Antonio-1110/RB4107_AY2627/docs/safety_rules.md

# Safety rules: what the controller does, and when

<!-- Generated by tools/safety_rules.py from firmware/components/safety/src/safety_rules.def. Do not edit: change the table and run `python3 tools/safety_rules.py gen`. -->

Every condition the S3 controller reacts to, and what it does. The state
machine runs from the same table this page is generated from
([`safety_rules.def`](../firmware/components/safety/src/safety_rules.def)), so
the transitions below are exactly what the firmware does. Values in **bold**
are the menuconfig defaults. The dashboard changes the ones listed in the last
section and shows the values in force; the rest are fixed (menuconfig or safety.c). The
reasons behind the rules are in [safety_state_machine.md](safety_state_machine.md).

## Outputs per state

| State | Buzzer | Shutdown output (latched) |
|---|---|---|
| BOOT | off | released |
| SELF_TEST | off | released |
| IDLE | off | released |
| MONITORING | off | released |
| UNATTENDED | off | released |
| WARNING | warning pattern | released |
| SHUTDOWN | shutdown pattern | **active** |
| FAULT | fault pattern | released |

## A. What the controller believes about its inputs

| # | When | Result | Code |
|---|---|---|---|
| A1 | A node sends nothing for **2 s** (stale) or **10 s** (offline), or its sensor reports invalid | That sensor's reading is UNKNOWN | `sensor_node_evaluate()` in `sensor_node/src/sensor_node.c` |
| A2 | "At the stove" (**"every working radar sees them"**): any working radar says absent | ABSENT | `presence_fuse_all()` in `sensor_node/src/sensor_node.c` |
| A3 | "At the stove": every working radar sees someone (a radar that is down is not asked) | PRESENT | `presence_fuse_all()` in `sensor_node/src/sensor_node.c` |
| A4 | No radar is working | UNKNOWN: a dashboard flag, never FAULT | `presence_fuse_all()` in `sensor_node/src/sensor_node.c` |
| A5 | Fusion set to "either radar sees them" (menuconfig or dashboard) | PRESENT if any radar sees someone; ABSENT only if all validly say absent | `presence_fuse()` in `sensor_node/src/sensor_node.c` |
| A6 | Radar rules set to enforce (default **"observe: computed and reported, not used"**): a radar sees someone but not for **4 s** with **1.5 s** stationary and within **60 cm** over **4 s** | That radar counts as absent (only passing). In observe mode the verdict is shown but not used | `node_set_inputs()` in `sensor_node/src/sensor_node.c` |
| A7 | Presence UNKNOWN while cooking | Counts as ABSENT. With nothing cooking, UNKNOWN starts no timer | `effective_presence()` in `safety/src/safety.c` |
| A8 | Thermal camera lost or invalid | Dashboard flag only. Cooking state, tier and a running countdown are kept | `safety_step()` in `safety/src/safety.c` |

## B. Cooking on or off (hottest pixel)

| # | When | Result | Code |
|---|---|---|---|
| B1 | Not cooking, and the hottest pixel reaches the cooking temperature **50 °C** (dashboard can change it), unless it is still falling (B6) | Cooking. A pan that is hot but falling (one just put in view, or switched off) is not cooking yet; it counts as cooking once the fall is under **0.2 °C/min** per minute. An unknown rate never blocks | `safety_step()` in `safety/src/safety.c` |
| B2 | Not cooking, above the off temperature and rising at least the heat-on rate (**0 °C/min**; 0 = this rule is off), and not still falling (B6) | Cooking | `safety_step()` in `safety/src/safety.c` |
| B3 | Cooking, and the hottest pixel falls below the off temperature **47 °C**: a pan that holds steady or is turned down has to fall this far | Not cooking | `safety_step()` in `safety/src/safety.c` |
| B6 | Cooking, the hottest pixel below **60 °C** and the thermal node's rate falling by **0.5 °C/min** per minute or more | Not cooking, even above the off temperature (B3). A pan that is still hot but cooling down stops counting as cooking | `safety_step()` in `safety/src/safety.c` |
| B4 | The dashboard sets a new cooking temperature | The off temperature moves with it, keeping the menuconfig gap (**50 °C** - **47 °C**) | `apply_cooking_temp()` in `rb_controller/src/rb_controller.c` |
| B5 | Every step: the thermal node's room temperature (the 10th-percentile pixel of the frame) | The room temperature in use, kept between **36 °C** and **45 °C**; **38 °C** without a camera reading. D1 and D5 compare the pan with it | `room_update()` in `safety/src/safety.c` |

## C. Timers

| # | When | Result | Code |
|---|---|---|---|
| C1 | First ABSENT reading | The absence count starts. A presence blip does not restart it; only a confirmed return (D4) stops it | `safety_step()` in `safety/src/safety.c` |
| C2 | Entering UNATTENDED | The countdown is counted from when the absence began, never from before cooking started | `on_enter()` in `safety/src/safety.c` |
| C3 | Hottest pixel below every hotter tier (tier 1: a simmer, boiling water) | The base times: buzzer after **150 s**, shutdown after **300 s** | `update_tier()` in `safety/src/safety.c` |
| C4 | Hottest pixel at least **100 °C** (tier 2), **150 °C** (tier 3), **200 °C** (tier 4) or **250 °C** (tier 5), for **4 s** | Buzzer / shutdown after **120 s** / **240 s** (tier 2), **90 s** / **180 s** (tier 3), **60 s** / **120 s** (tier 4), **30 s** / **60 s** (tier 5), if shorter than the base times. The hottest tier that applies wins | `update_tier()` in `safety/src/safety.c` |
| C5 | Rate rule (**on** by default): the temperature, plus its rise over the last **30 s** times a tier's buzzer time, reaches that tier's temperature, for **4 s** | That tier already: the buzzer sounds no later than the moment the pan would get there. The rise is the median of the newer half of the window minus the median of the older half, so one bad frame fakes no rise. Only a rise counts | `tier_for()` in `safety/src/safety.c` |
| C6 | **10 °C** below the tier's threshold (and not heading back, C5) for **20 s** | Back to the lower tier | `update_tier()` in `safety/src/safety.c` |
| C7 | The tier changes during a countdown | The countdown is not restarted: the time already away counts against the new limits. If they are already passed the buzzer sounds at once, and the shutdown waits for **10 s** of buzzer | `evaluate()` in `safety/src/safety.c` |
| C8 | Someone is seen during UNATTENDED or WARNING | The countdown stands still. At most **30 s** per countdown, and at most **25 %** of the shutdown time | `pause_clock()` in `safety/src/safety.c` |

## D. Holds and returns

| # | When | Result | Code |
|---|---|---|---|
| D1 | Cooling: a straight line fitted to the hot region (the mean around the hottest pixel) over the last **120 s** (at least **12** samples over **60 s**; recent samples count more, and samples a first fit misses by over **3** robust SDs, at least **0.5 °C**, are left out) shows the pan falling at least as fast as cooling alone would make a pan that settles **3 °C** below the only-cooling line fall: (T - line + margin) / tau. The rate must be clear of that by **2** standard errors of the fit. The line is **10 °C** above the room temperature (B5), but never above the cooking temperature: Newton cooling settles at the room. T + tau x rate (where it is heading) also rose at most **8 °C/min** over the last minute. tau comes from the cookware profile (**"mixed / unknown (10 min)"**) | The pan counts as only cooling. Ends when it falls slower than a pan settling **3 °C** above the line would, or T + tau x rate climbs faster than **16 °C/min** plus its own noise (**2** x 1.4 x tau x the rate's standard error). With too little data, a lost camera or the trend judgment turned off (it is **on** by default), heat counts as going in | `judge_heat()` in `safety/src/safety.c` |
| D2 | A buzzer or shutdown comes due while the pan is only cooling (D1) | It waits (cooling hold), at most **4** tau and never over **3600 s**. The countdown keeps counting; a buzzer already sounding keeps sounding | `hold_reason()` in `safety/src/safety.c` |
| D3 | A step comes due while someone is seen but not yet confirmed (D4) | It waits (return hold), at most **5 s** + **1 s** | `hold_reason()` in `safety/src/safety.c` |
| D4 | Someone returns: PRESENT for **5 s**, absent gaps under **1 s** forgiven, still present at the end | Return confirmed (used by T10, T13) | `present_confirmed()` in `safety/src/safety.c` |
| D5 | A buzzer or shutdown comes due while the temperature is falling (over the last **30 s**) by at least **2** % per minute of its heat above the room (B5), and at least **1 °C/min**; near the room even a switched-off pan falls slowly. And the trend has not confirmed heat going in (the fit of D1 falling slower than a pan settling **3 °C** above the only-cooling line would, and T + tau x rate moving at most **8 °C/min**) | It waits (falling hold; **on** by default): a falling pan is moving away from danger. Ends at once when the temperature stops falling or heat is confirmed (a lowered flame), and after **90 s** at most per countdown (a check before it, D6, uses up the same limit). A pan that is only cooling (D1) gets the cooling hold instead | `falling_hold()` in `safety/src/safety.c` |
| D6 | Absence confirmed while cooking (MONITORING): for the first half of **30 s** of the absence (a fall takes that long to show), unless the pan is rising or the buzzer is already due; after that, while the pan falls as for the falling hold (D5) | The countdown waits to start (checking: stove off or turned down?), so no unattended episode opens. It still counts from when the absence began (C2), so the buzzer is never later for it. Ends when the pan is not falling after the first look (the countdown starts), when cooking stops (T08, B6), on a confirmed return, and after **90 s** at most, shared with D5. A countdown that starts after a check that saw the pan falling counts as held: the buzzer lasts **30 s** before a shutdown | `g_absent_unheld()` in `safety/src/safety.c` |

## T. State transitions

Checked on every step in this order; the first rule of the current state that holds is taken.

| # | From | When | To | Reported reason |
|---|---|---|---|---|
| T01 | BOOT | Always | **SELF_TEST** | boot complete |
| T02 | SELF_TEST | The self-test reports FAIL | **FAULT** | self-test failed |
| T03 | SELF_TEST | The self-test reports PASS | **IDLE** | self-test passed |
| T04 | SELF_TEST | No self-test result within **10 s** | **FAULT** | self-test timeout |
| T05 | any cooking-related state (IDLE, MONITORING, UNATTENDED, WARNING) | The self-test (the shutdown output's read-back, every **1 s**) no longer passes | **FAULT** | self-test not passed |
| T06 | any cooking-related state (IDLE, MONITORING, UNATTENDED, WARNING) | A controller fault in the fault list (shutdown output, self-test). A lost sensor is not one (A4, A8) | **FAULT** | safety-relevant fault active |
| T07 | IDLE | Cooking (B1, B2) | **MONITORING** | heating detected |
| T08 | MONITORING | Not cooking (B3) | **IDLE** | heating stopped |
| T09 | MONITORING | ABSENT for **1 s** (C1), and not checking (D6) | **UNATTENDED** | person absent |
| T10 | UNATTENDED | Return confirmed (D4). The countdown is cancelled | **MONITORING** | person returned |
| T11 | UNATTENDED | Not cooking (B3), with the cooling policy **"return to IDLE and cancel the timers"**. The countdown is cancelled | **IDLE** | heating stopped while unattended |
| T12 | UNATTENDED | Unattended for the warning time (**150 s**, shorter in a hotter tier C4, C5) and no hold (D2, D3, D5) | **WARNING** | unattended timeout |
| T13 | WARNING | Return confirmed (D4). The warning exit is **"return to MONITORING"**; if menuconfig changes it to acknowledge, a reset is needed as well | **MONITORING** | person returned during warning |
| T14 | WARNING | Not cooking (B3), with the cooling policy **"return to IDLE and cancel the timers"**. The countdown is cancelled | **IDLE** | heating stopped during warning |
| T15 | WARNING | Unattended for the shutdown time (**300 s**, counted from **"start of UNATTENDED (total unattended time)"**, shorter in a hotter tier), no hold (D2, D3, D5), and the buzzer has sounded at least **30 s** if a hold happened, or **10 s** if a tier made the shutdown due at once | **SHUTDOWN** | shutdown timeout |
| T16 | SHUTDOWN | Operator reset (dashboard button or console reset). Nothing else leaves SHUTDOWN; a reboot also clears it. All timing starts over | **IDLE** | operator reset |
| T17 | FAULT | Fault cleared, not cooking | **IDLE** | fault cleared, no heating |
| T18 | FAULT | Fault cleared, cooking, PRESENT | **MONITORING** | fault cleared, person present |
| T19 | FAULT | Fault cleared, cooking, nobody seen. A countdown already running carries on; otherwise it counts from when the fault began | **UNATTENDED** | fault cleared, person absent |
| T20 | FAULT | The countdown reached its shutdown time: a fault never postpones it | **SHUTDOWN** | shutdown timeout reached during fault |
| T21 | FAULT | In FAULT for **90 s** (0 = never, menuconfig only) | **SHUTDOWN** | fault persisted |

SHUTDOWN is left only by T16. A state not in the table goes to FAULT ("invalid state").

## X. Outside the state machine

| # | When | Result | Code |
|---|---|---|---|
| X2 | MQTT, Django, the laptop or the network is down | No effect on any rule: the safety task never waits on them, and the settings the dashboard gave it stay in force (saved on the controller) | `safety_task()` in `rb_controller/src/rb_controller.c` |

## Settings

Menuconfig: RB4107 configuration. Values in Kconfig units.

| Setting | Default | What it is |
|---|---|---|
| `RB_CTRL_NODE_OFFLINE_MS` | 10000 | Node OFFLINE after (ms) without a packet |
| `RB_CTRL_NODE_STALE_MS` | 2000 | Node STALE after (ms) without a packet |
| `RB_CTRL_PRESENCE_FUSION` | every working radar sees them | Someone counts as at the stove when ... |
| `RB_CTRL_RADAR_DWELL_MS` | 4000 | Time in the cook zone needed to count as dwelling (ms) |
| `RB_CTRL_RADAR_RULES` | observe: computed and reported, not used | Radar state and distance rules (placeholder, untuned) |
| `RB_CTRL_RADAR_SETTLE_SPAN_CM` | 60 | ... to within a span of (cm) |
| `RB_CTRL_RADAR_SETTLE_WINDOW_MS` | 4000 | The distance must have settled over the last (ms) ... |
| `RB_CTRL_RADAR_STATIONARY_MIN_MS` | 1500 | ... of which as a stationary target at least (ms) |
| `RB_SAFETY_ABSENCE_DEBOUNCE_MS` | 1000 | Absence must last (ms) before UNATTENDED |
| `RB_SAFETY_COOKING_TREND` | y | Judge from the temperature trend whether heat is going in |
| `RB_SAFETY_COOKWARE` | mixed / unknown (10 min) | Cookware profile (how fast the pans lose heat) |
| `RB_SAFETY_COOLING` | return to IDLE and cancel the timers | Pan drops below the cooking temperature while UNATTENDED/WARNING |
| `RB_SAFETY_FALLING_HOLD` | y | Hold a due buzzer or shutdown while the temperature is falling |
| `RB_SAFETY_FAULT_SHUTDOWN_S` | 90 | Shut down after this long in FAULT (s, 0 = never) |
| `RB_SAFETY_HEAT_OFF_DC` | 470 | Cooking over below hottest-pixel temperature (0.1 degC) |
| `RB_SAFETY_HEAT_ON_DC` | 500 | Cooking detected at hottest-pixel temperature (0.1 degC) |
| `RB_SAFETY_HEAT_ON_RATE_DC_PER_MIN` | 0 | Also detect cooking when rising at least (0.1 degC/min), 0 = off |
| `RB_SAFETY_PAUSE_BUDGET_PCT` | 25 | ... and at most this share of the shutdown time (%) |
| `RB_SAFETY_PAUSE_BUDGET_S` | 30 | Pause budget per timeline (s, 0 = never pause) |
| `RB_SAFETY_PRESENCE_RETURN_DEBOUNCE_MS` | 5000 | Presence must last (ms) to cancel UNATTENDED/WARNING |
| `RB_SAFETY_PRESENCE_RETURN_GAP_MS` | 1000 | Gaps shorter than this (ms) don't restart the presence count |
| `RB_SAFETY_SELF_TEST_TIMEOUT_MS` | 10000 | Self-test timeout (ms) |
| `RB_SAFETY_SHUTDOWN_TIMEOUT_S` | 300 | Shutdown timeout (s) |
| `RB_SAFETY_SHUTDOWN_TIMING` | start of UNATTENDED (total unattended time) | Shutdown timeout counts from |
| `RB_SAFETY_TEMP_TIERS` | y | Shorter buzzer and shutdown times for hotter pans |
| `RB_SAFETY_TIER_2_SHUTDOWN_S` | 240 | Tier 2: shutdown time (s, counted like the base shutdown time) |
| `RB_SAFETY_TIER_2_TEMP_DC` | 1000 | Tier 2 from a hottest-pixel temperature of (0.1 degC) |
| `RB_SAFETY_TIER_2_WARNING_S` | 120 | Tier 2: unattended time before WARNING (s) |
| `RB_SAFETY_TIER_3_SHUTDOWN_S` | 180 | Tier 3: shutdown time (s, counted like the base shutdown time) |
| `RB_SAFETY_TIER_3_TEMP_DC` | 1500 | Tier 3 from a hottest-pixel temperature of (0.1 degC) |
| `RB_SAFETY_TIER_3_WARNING_S` | 90 | Tier 3: unattended time before WARNING (s) |
| `RB_SAFETY_TIER_4_SHUTDOWN_S` | 120 | Tier 4: shutdown time (s, counted like the base shutdown time) |
| `RB_SAFETY_TIER_4_TEMP_DC` | 2000 | Tier 4 from a hottest-pixel temperature of (0.1 degC) |
| `RB_SAFETY_TIER_4_WARNING_S` | 60 | Tier 4: unattended time before WARNING (s) |
| `RB_SAFETY_TIER_5_SHUTDOWN_S` | 60 | Tier 5: shutdown time (s, counted like the base shutdown time) |
| `RB_SAFETY_TIER_5_TEMP_DC` | 2500 | Tier 5 from a hottest-pixel temperature of (0.1 degC) |
| `RB_SAFETY_TIER_5_WARNING_S` | 30 | Tier 5: unattended time before WARNING (s) |
| `RB_SAFETY_TIER_RATE` | y | Also use the tier a rising pan is heading for |
| `RB_SAFETY_WARNING_EXIT` | return to MONITORING | Person returns during WARNING |
| `RB_SAFETY_WARNING_TIMEOUT_S` | 150 | Unattended time before WARNING (s) |
| `RB_SHUTDOWN_VERIFY_PERIOD_MS` | 1000 | Read back and verify the relay output every (ms) |

## Fixed constants in safety.c

| Constant | Value | Note |
|---|---|---|
| `TIER_UP_PERSIST_MS` | 4000 | a hotter tier takes over after holding this long |
| `TIER_DOWN_PERSIST_MS` | 20000 | a cooler one only after this long ... |
| `TIER_HYST_C` | 10.0 | ... and this far below the threshold |
| `LATE_WARNING_MIN_MS` | 10000 | buzzer before a shutdown that was already due |
| `TREND_SAMPLE_MS` | 2000 | one sample per 2 s |
| `TREND_GAP_RESET_MS` | 15000 | a longer silence starts the trend over |
| `TREND_STALE_MS` | 30000 | no sample for this long: the trend is unknown |
| `TREND_DEFAULT_WINDOW_MS` | 120000 | regression window when the config leaves it 0 |
| `TREND_MIN_SPAN_MS` | 60000 | needs at least this much history ... |
| `TREND_MIN_SAMPLES` | 12 | ... and this many samples |
| `TREND_CONFIDENCE` | 2.0 |  |
| `TREND_OUTLIER_MADS` | 3.0 | a sample this many robust SDs off the first fit is left out of the second |
| `TREND_OUTLIER_MIN_C` | 0.5 | ... but never one closer than this |
| `TREND_HALF_LIFE_MS` | 30000.0 | recent samples count more: a pan that was steady and now cools shows up sooner |
| `SETTLE_MARGIN_C` | 3.0 | hysteresis on the cooling decision |
| `HEAT_FALLING_OFF_C` | 60.0 |  |
| `HEAT_FALLING_C_PER_MIN` | 0.5 |  |
| `HEAT_FALLING_END_C_PER_MIN` | 0.2 |  |
| `ROOM_MIN_C` | 36.0 |  |
| `ROOM_MAX_C` | 45.0 |  |
| `ROOM_FALLBACK_C` | 38.0 |  |
| `ROOM_MARGIN_C` | 10.0 |  |
| `SETTLE_HIST_SAMPLE_MS` | 5000 | the settling estimate is remembered every 5 s ... |
| `SETTLE_DRIFT_WINDOW_MS` | 60000 | ... and its rise measured over a minute |
| `SETTLE_MAX_DRIFT_C_PER_MIN` | 8.0 | to start believing "cooling" |
| `SETTLE_EXIT_DRIFT_C_PER_MIN` | 16.0 | to stop believing it (hysteresis: camera noise must not drop a hold) |
| `RISING_C_PER_MIN` | 0.5 | faster than this is "heating", otherwise "holding" |
| `COOLING_HOLD_MAX_MS` | 3600000 | a cooling hold never lasts longer than an hour ... |
| `COOLING_HOLD_TAUS` | 4.0 | ... nor longer than 4 time constants: a pan still hot after that is not just cooling |
| `WARNING_MIN_AFTER_HOLD_MS` | 30000 | buzzer before the shutdown after any hold |
| `TIER_RATE_WINDOW_MS` | 30000 | rate for the tiers and the falling hold fitted over the last 30 s |
| `FALLING_SHARE_PCT_PER_MIN` | 2.0 | falling = losing at least this share of the heat above the room per minute |
| `FALLING_RATE_C_PER_MIN` | 1.0 | ... and at least this fast |
| `FALLING_HOLD_MAX_MS` | 90000 | a falling hold lasts at most this long per timeline |
| `SAFETY_FAST_RATE_MAX` | 64 | samples in that window at most: up to 126 s |

## Changing them from the dashboard

The dashboard's Safety tab changes the cooking temperature, cookware profile, temperature tiers,
presence filter and buzzer/shutdown times, fusion and pause budget, and the radar rules, plus the
settings below ([`rb_params.def`](../firmware/components/rb_params/include/rb_params.def)) under
each card's **More settings**. The controller saves them until **Restore menuconfig defaults** is pressed.
Everything else in these rules is fixed.

| Setting | Key | Default | Range |
|---|---|---|---|
| Cooking ends this far below the cooking temperature | `heat_off_gap_dc` | 3 °C | 0 °C to 100 °C |
| Hold while the pan is only cooling | `cooking_trend` | on | off / on |
| Maximum cooling hold | `cooling_hold_max_ms` | 3600 s | 60 s to 14400 s |
| Hold while the pan temperature is falling | `falling_hold` | on | off / on |
| Maximum falling hold | `falling_hold_max_ms` | 90 s | 10 s to 600 s |
| Minimum buzzer warning before shut-off after a hold | `warning_min_after_hold_ms` | 30 s | 1 s to 600 s |
| Apply a hotter tier early when the pan heats quickly | `tier_rate` | on | off / on |
| Gas shut-off after a controller fault lasting | `fault_shutdown_ms` | 90 s | 10 s to 3600 s |
