Antonio-1110/RB4107_AY2627/docs/configuration.md

# Configuration reference

Generated by `tools/diagnostics/kconfig_doc.py` from
[`firmware/components/rb_config/Kconfig`](../firmware/components/rb_config/Kconfig),
which is the one place every tunable is defined. Change values with
`idf.py menuconfig` → **RB4107 configuration**, or per project in `sdkconfig.defaults`.
Items flagged ⚠ are not yet confirmed on hardware or still open (see the GitHub issues).

## Logging

| Option | Description | Default | Range | |
|---|---|---|---|---|
| `CONFIG_RB_LOG_DEBUG_TAGS` | Tags to raise to DEBUG at boot (comma separated) | `""` |  |  |
| `CONFIG_RB_LOG_QUIET_TAGS` | Tags to lower to WARN at boot (comma separated) | `""` |  |  |

## ESP-NOW link (shared by node and controller)

| Option | Description | Default | Range | |
|---|---|---|---|---|
| `CONFIG_RB_ESPNOW_CHANNEL` | Wi-Fi channel used for ESP-NOW | `1` | 1 – 13 |  |
| `CONFIG_RB_ESPNOW_FOLLOW_CHANNEL` | Nodes: follow the controller when it changes channel | `y` |  | ⚠ |
| `CONFIG_RB_ESPNOW_LOST_FAILURES` | Nodes: search after this many unacknowledged packets in a row | `5` | 2 – 50 |  |

## Sensor node (ESP32-C6)

| Option | Description | Default | Range | |
|---|---|---|---|---|
| `CONFIG_RB_NODE_ID` | Sensor node ID | `1` | 1 – 65535 |  |
| `CONFIG_RB_NODE_ID_BY_MAC` | Node ID by MAC address (overrides Sensor node ID) | `""` |  |  |
| `CONFIG_RB_NODE_STATUS_LED_GPIO` | Status LED GPIO (-1 = none) | `15` | -1 – 30 |  |
| `CONFIG_RB_NODE_HEALTH_LOG_PERIOD_MS` | Board health log period (ms) | `10000` | 1000 – 600000 |  |
| `CONFIG_RB_NODE_CONTROLLER_MAC` | Controller (ESP32-S3) Wi-Fi STA MAC address | `"FF:FF:FF:FF:FF:FF"` |  |  |
| `CONFIG_RB_NODE_DATA_PERIOD_MS` | Data (PRESENCE_DATA / THERMAL_DATA) transmit period (ms) | `500` | 100 – 10000 |  |
| `CONFIG_RB_NODE_HEARTBEAT_PERIOD_MS` | HEARTBEAT transmit period (ms) | `1000` | 200 – 60000 |  |
| `CONFIG_RB_MLX_STALE_TIMEOUT_MS` | Thermal reading goes invalid after (ms) without a good frame | `3000` | 500 – 60000 |  |

## Sensor node (ESP32-C6) → C4002 presence sensor

| Option | Description | Default | Range | |
|---|---|---|---|---|
| `CONFIG_RB_C4002_UART_PORT` | UART port | `1` | 0 – 1 |  |
| `CONFIG_RB_C4002_RX_GPIO` | ESP32 RX GPIO (wired to C4002 TX) | `4` | 0 – 30 |  |
| `CONFIG_RB_C4002_TX_GPIO` | ESP32 TX GPIO (wired to C4002 RX) | `5` | 0 – 30 |  |
| `CONFIG_RB_C4002_OUT_GPIO` | C4002 OUT pin GPIO (-1 = not wired) | `-1` | -1 – 30 |  |
| `CONFIG_RB_C4002_BAUD` | Baud rate | `115200` |  |  |
| `CONFIG_RB_C4002_STALE_TIMEOUT_MS` | Reading goes invalid after (ms) without a report | `3000` | 200 – 60000 |  |
| `CONFIG_RB_C4002_APPLY_SETTINGS` | Push the detection settings below to the sensor at boot | `y` |  |  |
| `CONFIG_RB_C4002_REPORT_PERIOD_DS` | Report period (0.1 s units) | `5` | 1 – 5 |  |
| `CONFIG_RB_C4002_RANGE_MIN_CM` | Detection range minimum (cm) | `0` | 0 – 1100 |  |
| `CONFIG_RB_C4002_RANGE_MAX_CM` | Detection range maximum (cm) | `500` | 0 – 1100 |  |
| `RB_C4002_RESOLUTION` (choice) | Distance gate resolution: `CONFIG_RB_C4002_RESOLUTION_80CM` = 80 cm (15 gates, ~11 m); `CONFIG_RB_C4002_RESOLUTION_20CM` = 20 cm (25 gates, ~4.9 m) | `CONFIG_RB_C4002_RESOLUTION_20CM` |  |  |
| `CONFIG_RB_C4002_MOTION_SENSITIVITY` | Motion sensitivity group (0 low, 1 mid, 2 high) | `1` | 0 – 2 |  |
| `CONFIG_RB_C4002_PRESENCE_SENSITIVITY` | Static presence sensitivity group (0 low, 1 mid, 2 high) | `1` | 0 – 2 |  |
| `CONFIG_RB_C4002_DISAPPEAR_DELAY_S` | Target disappear delay (s) | `1` | 0 – 65535 |  |
| `CONFIG_RB_C4002_LOCK_TIME_DS` | Lock time after a target leaves (0.1 s units) | `10` | 2 – 100 |  |
| `CONFIG_RB_C4002_REMOTE_TUNING` | Accept C4002 settings and calibration from the dashboard | `y` |  |  |
| `CONFIG_RB_C4002_LIVE_PERIOD_MS` | Send raw C4002 results for the dashboard's live view every (ms), 0 = off | `250` | 0 – 10000 |  |
| `CONFIG_RB_C4002_ENV_CALIBRATION_AT_BOOT` | Run environment calibration at boot (area must be empty) | `n` |  |  |
| `CONFIG_RB_C4002_ENV_CALIBRATION_S` | Environment calibration duration (s) | `30` | 1 – 600 |  |

## Sensor node (ESP32-C6) → MLX90640 thermal sensor

| Option | Description | Default | Range | |
|---|---|---|---|---|
| `CONFIG_RB_MLX_I2C_PORT` | I2C port | `0` | 0 – 1 |  |
| `CONFIG_RB_MLX_SDA_GPIO` | SDA GPIO | `6` | 0 – 30 |  |
| `CONFIG_RB_MLX_SCL_GPIO` | SCL GPIO | `7` | 0 – 30 |  |
| `CONFIG_RB_MLX_I2C_HZ` | I2C clock (Hz) | `400000` | 100000 – 1000000 |  |
| `CONFIG_RB_MLX_ADDRESS` | I2C address | `0x33` |  |  |
| `RB_MLX_REFRESH` (choice) | Sub-page refresh rate: `CONFIG_RB_MLX_REFRESH_2HZ` = 2 Hz; `CONFIG_RB_MLX_REFRESH_4HZ` = 4 Hz; `CONFIG_RB_MLX_REFRESH_8HZ` = 8 Hz | `CONFIG_RB_MLX_REFRESH_4HZ` |  |  |
| `CONFIG_RB_MLX_EMISSIVITY_PCT` | Emissivity (percent) | `95` | 10 – 100 |  |
| `CONFIG_RB_MLX_FRAME_TIMEOUT_MS` | Frame read timeout (ms) | `2000` | 100 – 10000 |  |

## Sensor node (ESP32-C6) → Thermal feature extraction

| Option | Description | Default | Range | |
|---|---|---|---|---|
| `CONFIG_RB_THERMAL_HOT_PIXEL_THRESHOLD_DC` | Hot pixel threshold (0.1 degC) | `500` | -400 – 3000 |  |
| `CONFIG_RB_THERMAL_HOT_REGION_RADIUS` | Hot region radius (pixels) | `1` | 0 – 4 |  |
| `CONFIG_RB_THERMAL_RATE_WINDOW_S` | Rate-of-change window (s) | `30` | 4 – 600 |  |
| `CONFIG_RB_THERMAL_VALID_MIN_DC` | Lowest plausible pixel temperature (0.1 degC) | `-400` | -400 – 0 |  |
| `CONFIG_RB_THERMAL_VALID_MAX_DC` | Highest plausible pixel temperature (0.1 degC) | `3000` | 500 – 4000 |  |
| `CONFIG_RB_THERMAL_MAX_INVALID_PIXELS` | Invalid pixels tolerated per frame | `8` | 0 – 768 |  |
| `CONFIG_RB_THERMAL_DIAG_DUMP_EVERY` | Dump the raw frame over serial every N frames (0 = never) | `0` | 0 – 10000 |  |
| `CONFIG_RB_THERMAL_HEATMAP` | Send the heat-map picture to the controller (dashboard) | `y` |  |  |
| `CONFIG_RB_THERMAL_HEATMAP_PERIOD_MS` | Heat-map picture period (ms) | `3000` | 1000 – 10000 |  |
| `CONFIG_RB_THERMAL_REMOTE_THRESHOLD` | Accept the hot-pixel threshold from the controller | `y` |  |  |

## Controller board (Waveshare ESP32-S3-POE-ETH-8DI-8DO)

| Option | Description | Default | Range | |
|---|---|---|---|---|
| `CONFIG_RB_S3_I2C_PORT` | Board I2C port | `0` | 0 – 1 |  |
| `CONFIG_RB_S3_I2C_SDA_GPIO` | Board I2C SDA GPIO | `42` | 0 – 48 |  |
| `CONFIG_RB_S3_I2C_SCL_GPIO` | Board I2C SCL GPIO | `41` | 0 – 48 |  |
| `CONFIG_RB_S3_I2C_HZ` | Board I2C clock (Hz) | `100000` | 100000 – 400000 |  |
| `CONFIG_RB_S3_TCA9554_ADDRESS` | TCA9554 relay expander I2C address | `0x20` |  |  |
| `CONFIG_RB_S3_PCF85063_ADDRESS` | PCF85063 RTC I2C address | `0x51` |  |  |
| `CONFIG_RB_S3_BOOT_BUTTON_GPIO` | BOOT button GPIO (-1 = none) | `0` | -1 – 48 |  |
| `CONFIG_RB_S3_HEALTH_LOG_PERIOD_MS` | Controller health log period (ms) | `10000` | 1000 – 600000 |  |

## Controller board (Waveshare ESP32-S3-POE-ETH-8DI-8DO) → Buzzer

| Option | Description | Default | Range | |
|---|---|---|---|---|
| `CONFIG_RB_BUZZER_GPIO` | Buzzer GPIO (-1 = none) | `46` | -1 – 48 |  |
| `CONFIG_RB_BUZZER_ACTIVE_LEVEL` | Level that sounds the buzzer | `1` | 0 – 1 |  |
| `RB_BUZZER_DRIVE` (choice) | Buzzer type: `CONFIG_RB_BUZZER_DRIVE_GPIO` = active buzzer (GPIO level); `CONFIG_RB_BUZZER_DRIVE_PWM` = passive buzzer (LEDC PWM tone) | `CONFIG_RB_BUZZER_DRIVE_PWM` |  |  |
| `CONFIG_RB_BUZZER_TONE_HZ` | Tone frequency (Hz) | `2700` | 200 – 10000 |  |

## Controller board (Waveshare ESP32-S3-POE-ETH-8DI-8DO) → Shutdown relay

| Option | Description | Default | Range | |
|---|---|---|---|---|
| `CONFIG_RB_SHUTDOWN_RELAY_CHANNEL` | Relay channel used for shutdown (1-8) | `1` | 1 – 8 |  |
| `CONFIG_RB_RELAY_ACTIVE_LEVEL` | TCA9554 output level that energises a relay | `0` | 0 – 1 |  |
| `RB_SHUTDOWN_POLARITY` (choice) | Relay polarity: `CONFIG_RB_SHUTDOWN_ENERGISE_TO_SHUT_DOWN` = energise relay to shut down (appliance on NC contact); `CONFIG_RB_SHUTDOWN_DEENERGISE_TO_SHUT_DOWN` = de-energise relay to shut down (appliance on NO contact, fail-safe) | `CONFIG_RB_SHUTDOWN_DEENERGISE_TO_SHUT_DOWN` |  |  |
| `RB_SHUTDOWN_BOOT_STATE` (choice) | Shutdown output at boot: `CONFIG_RB_SHUTDOWN_BOOT_RELEASED` = released (appliance powered); `CONFIG_RB_SHUTDOWN_BOOT_ACTIVE` = active (appliance off until the controller is running) | `CONFIG_RB_SHUTDOWN_BOOT_RELEASED` |  | ⚠ |
| `CONFIG_RB_SHUTDOWN_VERIFY_PERIOD_MS` | Read back and verify the relay output every (ms) | `1000` | 100 – 60000 |  |

## Controller board (Waveshare ESP32-S3-POE-ETH-8DI-8DO) → Time / RTC

| Option | Description | Default | Range | |
|---|---|---|---|---|
| `CONFIG_RB_TIME_TZ` | POSIX time zone for log/MQTT timestamps | `"SGT-8"` |  |  |
| `CONFIG_RB_TIME_NTP_SERVER` | SNTP server (empty = don't sync over the network) | `"pool.ntp.org"` |  |  |
| `CONFIG_RB_TIME_SET_RTC_FROM_BUILD` | If the RTC is invalid at boot, set it to the firmware build time | `n` |  |  |

## Controller board (Waveshare ESP32-S3-POE-ETH-8DI-8DO) → Sensor node link

| Option | Description | Default | Range | |
|---|---|---|---|---|
| `RB_CTRL_PRESENCE_FUSION` (choice) | Someone counts as at the stove when ...: `CONFIG_RB_CTRL_PRESENCE_FUSION_ALL` = every working radar sees them; `CONFIG_RB_CTRL_PRESENCE_FUSION_ANY` = either radar sees them (the earlier behaviour) | `CONFIG_RB_CTRL_PRESENCE_FUSION_ALL` |  |  |
| `RB_CTRL_RADAR_RULES` (choice) | Radar state and distance rules (placeholder, untuned): `CONFIG_RB_CTRL_RADAR_RULES_OFF` = off; `CONFIG_RB_CTRL_RADAR_RULES_OBSERVE` = observe: computed and reported, not used; `CONFIG_RB_CTRL_RADAR_RULES_ENFORCE` = enforce: a radar that only sees someone passing does not count as at the stove | `CONFIG_RB_CTRL_RADAR_RULES_OBSERVE` |  |  |
| `CONFIG_RB_CTRL_RADAR_QUIET_GAP_MS` | A none for this long ends an episode (ms) | `1500` | 200 – 10000 |  |
| `CONFIG_RB_CTRL_RADAR_DWELL_MS` | Time in the cook zone needed to count as dwelling (ms) | `4000` | 500 – 60000 |  |
| `CONFIG_RB_CTRL_RADAR_STATIONARY_MIN_MS` | ... of which as a stationary target at least (ms) | `1500` | 0 – 60000 |  |
| `CONFIG_RB_CTRL_RADAR_SETTLE_WINDOW_MS` | The distance must have settled over the last (ms) ... | `4000` | 500 – 30000 |  |
| `CONFIG_RB_CTRL_RADAR_SETTLE_SPAN_CM` | ... to within a span of (cm) | `60` | 5 – 500 |  |
| `CONFIG_RB_CTRL_RADAR_ZONE_MAX_CM` | Cook zone: targets up to this far from the radar (cm, 0 = no limit) | `0` | 0 – 1100 |  |
| `CONFIG_RB_CTRL_REMOTE_ATTENDANCE` | Accept the fusion and the pause budget from the dashboard | `y` |  |  |
| `CONFIG_RB_CTRL_REMOTE_RADAR_RULES` | Accept the radar state and distance rules from the dashboard | `y` |  |  |
| `CONFIG_RB_CTRL_PRESENCE_NODE_COUNT` | Number of presence nodes (C4002 radars) | `2` | 1 – 2 |  |
| `CONFIG_RB_CTRL_PRESENCE_A_NODE_ID` | Presence node A ID | `1` | 1 – 65535 |  |
| `CONFIG_RB_CTRL_PRESENCE_B_NODE_ID` | Presence node B ID | `2` | 1 – 65535 |  |
| `CONFIG_RB_CTRL_THERMAL_NODE_ID` | Thermal node ID | `3` | 1 – 65535 |  |
| `CONFIG_RB_CTRL_C4002_REMOTE_TUNING` | Relay C4002 tuning commands from the dashboard to the presence nodes | `y` |  |  |
| `CONFIG_RB_CTRL_REMOTE_RESET` | Accept the operator reset from the dashboard | `y` |  |  |
| `CONFIG_RB_CTRL_REMOTE_LOG` | Accept log level changes from the dashboard | `y` |  |  |
| `CONFIG_RB_CTRL_REMOTE_PRESENCE_FILTER` | Accept presence filter and buzzer/shutdown times from the dashboard | `y` |  |  |
| `CONFIG_RB_CTRL_REMOTE_COOKING_TEMP` | Accept the cooking temperature from the dashboard | `y` |  |  |
| `CONFIG_RB_CTRL_REMOTE_COOKWARE` | Accept the cookware profile from the dashboard | `y` |  |  |
| `CONFIG_RB_CTRL_REMOTE_TIERS` | Accept the temperature tiers from the dashboard | `y` |  |  |
| `CONFIG_RB_CTRL_REMOTE_PARAMS` | Accept the other safety settings from the dashboard | `y` |  |  |
| `CONFIG_RB_CTRL_RX_QUEUE_LEN` | ESP-NOW receive queue length | `16` | 4 – 64 |  |
| `CONFIG_RB_CTRL_NODE_STALE_MS` | Node STALE after (ms) without a packet | `2000` | 200 – 60000 |  |
| `CONFIG_RB_CTRL_NODE_OFFLINE_MS` | Node OFFLINE after (ms) without a packet | `10000` | 500 – 600000 |  |
| `CONFIG_RB_CTRL_NODE_RESTART_LIMIT` | Raise node_restarting after this many node reboots (0 = off) | `3` | 0 – 8 |  |
| `CONFIG_RB_CTRL_NODE_RESTART_WINDOW_S` | ... within this many seconds | `600` | 10 – 86400 |  |

## Controller board (Waveshare ESP32-S3-POE-ETH-8DI-8DO) → Tasks

| Option | Description | Default | Range | |
|---|---|---|---|---|
| `CONFIG_RB_CTRL_SAFETY_TASK_PRIO` | Safety task priority | `12` | 5 – 22 |  |
| `CONFIG_RB_CTRL_SAFETY_TICK_MS` | Safety task tick (ms) | `100` | 10 – 1000 |  |
| `CONFIG_RB_CTRL_EVENT_QUEUE_LEN` | Event queue length (safety -> telemetry) | `32` | 4 – 128 |  |
| `CONFIG_RB_CTRL_TELEMETRY_TASK_PRIO` | Telemetry task priority | `3` | 1 – 10 |  |

## Network (ESP32-S3)

| Option | Description | Default | Range | |
|---|---|---|---|---|
| `RB_NET_TYPE` (choice) | Controller network interface: `CONFIG_RB_NET_ETHERNET_WIFI` = Ethernet, Wi-Fi when Ethernet is down (unused); `CONFIG_RB_NET_ETHERNET` = Ethernet (on-board W5500, unused); `CONFIG_RB_NET_WIFI` = Wi-Fi station (default); `CONFIG_RB_NET_NONE` = none (local safety only); `CONFIG_RB_NET_QEMU_OPENETH` = QEMU emulated Ethernet (testing only, never on hardware) | `CONFIG_RB_NET_WIFI` |  |  |
| `CONFIG_RB_NET_USES_ETHERNET` |  | `y if RB_NET_ETHERNET || RB_NET_ETHERNET_WIFI` |  |  |
| `CONFIG_RB_NET_USES_WIFI` |  | `y if RB_NET_WIFI || RB_NET_ETHERNET_WIFI` |  |  |
| `CONFIG_RB_NET_FALLBACK_S` | Switch to Wi-Fi after Ethernet has had no IP address for (s) | `5` | 1 – 300 |  |

## Network (ESP32-S3) → W5500 Ethernet

| Option | Description | Default | Range | |
|---|---|---|---|---|
| `CONFIG_RB_ETH_SPI_HOST` | SPI host (1 = SPI2, 2 = SPI3) | `1` | 1 – 2 |  |
| `CONFIG_RB_ETH_SPI_MHZ` | SPI clock (MHz) | `20` | 5 – 40 |  |
| `CONFIG_RB_ETH_MOSI_GPIO` | MOSI GPIO | `13` |  |  |
| `CONFIG_RB_ETH_MISO_GPIO` | MISO GPIO | `14` |  |  |
| `CONFIG_RB_ETH_SCLK_GPIO` | SCLK GPIO | `15` |  |  |
| `CONFIG_RB_ETH_CS_GPIO` | CS GPIO | `16` |  |  |
| `CONFIG_RB_ETH_INT_GPIO` | INT GPIO (-1 = poll) | `12` | -1 – 48 |  |
| `CONFIG_RB_ETH_POLL_MS` | Poll period when INT is not used (ms) | `10` | 1 – 1000 |  |
| `CONFIG_RB_ETH_RST_GPIO` | PHY reset GPIO (-1 = not connected) | `-1` | -1 – 48 |  |

## Network (ESP32-S3) → Wi-Fi station

| Option | Description | Default | Range | |
|---|---|---|---|---|
| `CONFIG_RB_WIFI_SSID` | SSID | `""` |  |  |
| `CONFIG_RB_WIFI_PASSWORD` | Password | `""` |  |  |
| `CONFIG_RB_WIFI_SSID_2` | Backup SSID (empty = none, e.g. a phone hotspot) | `""` |  |  |
| `CONFIG_RB_WIFI_PASSWORD_2` | Backup password | `""` |  |  |
| `CONFIG_RB_WIFI_SWITCH_AFTER` | Switch to the other network after this many failed attempts | `3` | 1 – 20 |  |
| `CONFIG_RB_WIFI_MAX_BACKOFF_MS` | Longest reconnect back-off (ms) | `16000` | 1000 – 300000 |  |

## MQTT broker (MacBook)

| Option | Description | Default | Range | |
|---|---|---|---|---|
| `CONFIG_RB_BROKER_HOST` | Broker host (MacBook LAN IP or hostname) | `""` |  |  |
| `CONFIG_RB_BROKER_FALLBACK_HOST` | Fallback broker host (empty = none) | `""` |  |  |
| `CONFIG_RB_BROKER_FALLBACK_HOST_2` | Second fallback broker host, e.g. on the hotspot (empty = none) | `""` |  |  |
| `CONFIG_RB_BROKER_PORT` | Broker port | `1883` | 1 – 65535 |  |
| `CONFIG_RB_MQTT_CONTROLLER_ID` | Controller ID (MQTT client ID and JSON controller_id) | `"controller_01"` |  |  |
| `CONFIG_RB_MQTT_TOPIC_PREFIX` | Topic prefix | `"rb4107"` |  |  |
| `CONFIG_RB_MQTT_KEEPALIVE_S` | Keep-alive (s) | `15` | 5 – 600 |  |
| `CONFIG_RB_MQTT_RECONNECT_MS` | Reconnect interval (ms) | `5000` | 1000 – 120000 |  |
| `CONFIG_RB_MQTT_OUTBOX_LIMIT_KB` | Outbox limit while disconnected (KB) | `32` | 4 – 256 |  |
| `CONFIG_RB_MQTT_TELEMETRY_PERIOD_MS` | Periodic telemetry interval (ms) | `1000` | 200 – 60000 |  |
| `CONFIG_RB_MQTT_PUBLISH_SENSOR_TOPICS` | Also publish per-node presence/thermal topics every period | `y` |  |  |
| `CONFIG_RB_MQTT_PUBLISH_HEATMAP` | Publish the thermal node's heat-map pictures | `y` |  |  |
| `CONFIG_RB_MQTT_PUBLISH_LOG` | Publish the controller's log lines (dashboard Logs tab) | `y` |  |  |
| `CONFIG_RB_MQTT_LOG_BUFFER_LINES` | Log lines kept for the dashboard | `100` | 16 – 400 |  |
| `CONFIG_RB_MQTT_LOG_SKIP_TAGS` | Tags never sent to the dashboard (comma separated) | `"mqtt_client,outbox,transport_base,transport,esp-tls"` |  |  |

## Diagnostics / simulation

| Option | Description | Default | Range | |
|---|---|---|---|---|
| `CONFIG_RB_SIM_NODE` | Simulated sensor nodes instead of ESP-NOW | `n` |  |  |
| `CONFIG_RB_OUTPUTS_SIMULATED` | Simulated outputs (log only, don't drive the buzzer/relay) | `n` |  |  |
| `CONFIG_RB_DIAG_CONSOLE` | Diagnostic console (esp_console REPL on the serial port) | `n` |  |  |
| `CONFIG_RB_DIAG_CONTINUITY_MONITOR` | Critical-failure continuity monitor | `n` |  |  |
| `CONFIG_RB_DIAG_TEST_TIMERS_AT_BOOT` | Start with accelerated test timers | `n` |  |  |
| `CONFIG_RB_DIAG_TEST_WARNING_S` | Test mode: unattended time before WARNING (s) | `5` | 1 – 600 |  |
| `CONFIG_RB_DIAG_TEST_SHUTDOWN_S` | Test mode: shutdown timeout (s) | `10` | 2 – 600 |  |
| `CONFIG_RB_DIAG_TEST_FAULT_SHUTDOWN_S` | Test mode: shut down after this long in FAULT (s, 0 = never) | `10` | 0 – 600 |  |

## Safety logic (ESP32-S3)

| Option | Description | Default | Range | |
|---|---|---|---|---|
| `CONFIG_RB_SAFETY_SELF_TEST_TIMEOUT_MS` | Self-test timeout (ms) | `10000` | 1000 – 120000 |  |
| `CONFIG_RB_SAFETY_HEAT_ON_DC` | Cooking detected at hottest-pixel temperature (0.1 degC) | `500` | 0 – 3000 | ⚠ |
| `CONFIG_RB_SAFETY_HEAT_OFF_DC` | Cooking over below hottest-pixel temperature (0.1 degC) | `470` | 0 – 3000 | ⚠ |
| `CONFIG_RB_SAFETY_HEAT_ON_RATE_DC_PER_MIN` | Also detect cooking when rising at least (0.1 degC/min), 0 = off | `0` | 0 – 10000 | ⚠ |
| `CONFIG_RB_SAFETY_ABSENCE_DEBOUNCE_MS` | Absence must last (ms) before UNATTENDED | `1000` | 0 – 60000 |  |
| `CONFIG_RB_SAFETY_PRESENCE_RETURN_DEBOUNCE_MS` | Presence must last (ms) to cancel UNATTENDED/WARNING | `5000` | 0 – 60000 |  |
| `CONFIG_RB_SAFETY_PAUSE_BUDGET_S` | Pause budget per timeline (s, 0 = never pause) | `30` | 0 – 600 |  |
| `CONFIG_RB_SAFETY_PAUSE_BUDGET_PCT` | ... and at most this share of the shutdown time (%) | `25` | 0 – 100 |  |
| `CONFIG_RB_SAFETY_PRESENCE_RETURN_GAP_MS` | Gaps shorter than this (ms) don't restart the presence count | `1000` | 0 – 10000 |  |
| `CONFIG_RB_SAFETY_WARNING_TIMEOUT_S` | Unattended time before WARNING (s) | `150` | 1 – 3600 |  |
| `CONFIG_RB_SAFETY_SHUTDOWN_TIMEOUT_S` | Shutdown timeout (s) | `300` | 1 – 3600 |  |
| `RB_SAFETY_SHUTDOWN_TIMING` (choice) | Shutdown timeout counts from: `CONFIG_RB_SAFETY_SHUTDOWN_FROM_UNATTENDED` = start of UNATTENDED (total unattended time); `CONFIG_RB_SAFETY_SHUTDOWN_FROM_WARNING` = start of WARNING | `CONFIG_RB_SAFETY_SHUTDOWN_FROM_UNATTENDED` |  |  |
| `RB_SAFETY_WARNING_EXIT` (choice) | Person returns during WARNING: `CONFIG_RB_SAFETY_WARNING_EXIT_PRESENCE` = return to MONITORING; `CONFIG_RB_SAFETY_WARNING_EXIT_ACK` = stay in WARNING until the person acknowledges (reset input) | `CONFIG_RB_SAFETY_WARNING_EXIT_PRESENCE` |  | ⚠ |
| `RB_SAFETY_COOLING` (choice) | Pan drops below the cooking temperature while UNATTENDED/WARNING: `CONFIG_RB_SAFETY_COOLING_KEEP_TIMERS` = keep the timers running (old behaviour: shuts a cold stove off); `CONFIG_RB_SAFETY_COOLING_RETURN_TO_IDLE` = return to IDLE and cancel the timers | `CONFIG_RB_SAFETY_COOLING_RETURN_TO_IDLE` |  |  |
| `CONFIG_RB_SAFETY_COOKING_TREND` | Judge from the temperature trend whether heat is going in | `y` |  |  |
| `CONFIG_RB_SAFETY_TEMP_TIERS` | Shorter buzzer and shutdown times for hotter pans | `y` |  |  |
| `CONFIG_RB_SAFETY_TIER_2_TEMP_DC` | Tier 2 from a hottest-pixel temperature of (0.1 degC) | `1000` | 0 – 3000 |  |
| `CONFIG_RB_SAFETY_TIER_2_WARNING_S` | Tier 2: unattended time before WARNING (s) | `120` | 1 – 3600 |  |
| `CONFIG_RB_SAFETY_TIER_2_SHUTDOWN_S` | Tier 2: shutdown time (s, counted like the base shutdown time) | `240` | 1 – 3600 |  |
| `CONFIG_RB_SAFETY_TIER_3_TEMP_DC` | Tier 3 from a hottest-pixel temperature of (0.1 degC) | `1500` | 0 – 3000 |  |
| `CONFIG_RB_SAFETY_TIER_3_WARNING_S` | Tier 3: unattended time before WARNING (s) | `90` | 1 – 3600 |  |
| `CONFIG_RB_SAFETY_TIER_3_SHUTDOWN_S` | Tier 3: shutdown time (s, counted like the base shutdown time) | `180` | 1 – 3600 |  |
| `CONFIG_RB_SAFETY_TIER_4_TEMP_DC` | Tier 4 from a hottest-pixel temperature of (0.1 degC) | `2000` | 0 – 3000 |  |
| `CONFIG_RB_SAFETY_TIER_4_WARNING_S` | Tier 4: unattended time before WARNING (s) | `60` | 1 – 3600 |  |
| `CONFIG_RB_SAFETY_TIER_4_SHUTDOWN_S` | Tier 4: shutdown time (s, counted like the base shutdown time) | `120` | 1 – 3600 |  |
| `CONFIG_RB_SAFETY_TIER_5_TEMP_DC` | Tier 5 from a hottest-pixel temperature of (0.1 degC) | `2500` | 0 – 3000 |  |
| `CONFIG_RB_SAFETY_TIER_5_WARNING_S` | Tier 5: unattended time before WARNING (s) | `30` | 1 – 3600 |  |
| `CONFIG_RB_SAFETY_TIER_5_SHUTDOWN_S` | Tier 5: shutdown time (s, counted like the base shutdown time) | `60` | 1 – 3600 |  |
| `CONFIG_RB_SAFETY_TIER_RATE` | Also use the tier a rising pan is heading for | `y` |  |  |
| `CONFIG_RB_SAFETY_FALLING_HOLD` | Hold a due buzzer or shutdown while the temperature is falling | `y` |  |  |
| `RB_SAFETY_COOKWARE` (choice) | Cookware profile (how fast the pans lose heat): `CONFIG_RB_SAFETY_COOKWARE_MIXED` = mixed / unknown (10 min); `CONFIG_RB_SAFETY_COOKWARE_LIGHT` = light pans: woks, thin aluminium or stainless (5 min); `CONFIG_RB_SAFETY_COOKWARE_HEAVY` = heavy pans: cast iron, thick clad (15 min); `CONFIG_RB_SAFETY_COOKWARE_LIQUID` = pots with liquid: soup, stock, boiling water (40 min) | `CONFIG_RB_SAFETY_COOKWARE_MIXED` |  |  |
| `CONFIG_RB_SAFETY_FAULT_SHUTDOWN_S` | Shut down after this long in FAULT (s, 0 = never) | `90` | 0 – 3600 | ⚠ |
## Quick index

| What | Options |
|---|---|
| GPIO assignments | `RB_C4002_*_GPIO`, `RB_MLX_S*_GPIO`, `RB_NODE_STATUS_LED_GPIO`, `RB_S3_I2C_*`, `RB_BUZZER_GPIO` (`RB_ETH_*_GPIO` only for the unused Ethernet options) |
| Relay polarity | `RB_SHUTDOWN_POLARITY`, `RB_RELAY_ACTIVE_LEVEL`, `RB_SHUTDOWN_BOOT_STATE` |
| ESP-NOW peer MAC and channel | `RB_NODE_CONTROLLER_MAC`, `RB_ESPNOW_CHANNEL`, `RB_ESPNOW_FOLLOW_CHANNEL` (nodes follow the controller to the Wi-Fi router's channel, see [setup.md](setup.md#broker)) |
| Node IDs | `RB_NODE_ID` (each node; 1, 2 = presence, 3 = thermal), `RB_CTRL_PRESENCE_NODE_COUNT`, `RB_CTRL_PRESENCE_A_NODE_ID`, `RB_CTRL_PRESENCE_B_NODE_ID`, `RB_CTRL_THERMAL_NODE_ID` (controller) |
| Sensor timeouts | `RB_C4002_STALE_TIMEOUT_MS`, `RB_MLX_STALE_TIMEOUT_MS`, `RB_CTRL_NODE_STALE_MS`, `RB_CTRL_NODE_OFFLINE_MS` |
| Presence debounce | `RB_SAFETY_ABSENCE_DEBOUNCE_MS`, `RB_SAFETY_PRESENCE_RETURN_DEBOUNCE_MS`, `RB_SAFETY_PRESENCE_RETURN_GAP_MS` (also live from the dashboard, `RB_CTRL_REMOTE_PRESENCE_FILTER`). The S3 is the only place that debounces: the C4002's own disappear delay and lock time are fixed at 0 s and 0.2 s |
| Temperature thresholds | `RB_SAFETY_HEAT_ON_DC` (also from the dashboard and saved, `RB_CTRL_REMOTE_COOKING_TEMP`), `RB_SAFETY_HEAT_OFF_DC`, `RB_THERMAL_HOT_PIXEL_THRESHOLD_DC` (display only; the controller keeps it equal to the cooking temperature) |
| Temperature-rate thresholds | `RB_SAFETY_HEAT_ON_RATE_DC_PER_MIN`, `RB_THERMAL_RATE_WINDOW_S` |
| Warning / shutdown timeout | `RB_SAFETY_WARNING_TIMEOUT_S`, `RB_SAFETY_SHUTDOWN_TIMEOUT_S`, `RB_SAFETY_SHUTDOWN_TIMING` |
| Network interface | `RB_NET_TYPE` (Wi-Fi station by default; the controller is Wi-Fi only), `RB_WIFI_SSID`, `RB_WIFI_PASSWORD`, backup network `RB_WIFI_SSID_2`, `RB_WIFI_PASSWORD_2`, `RB_WIFI_SWITCH_AFTER` (see [setup.md](setup.md#phone-hotspot-as-a-backup)) |
| MQTT broker | `RB_BROKER_HOST`, `RB_BROKER_FALLBACK_HOST`, `RB_BROKER_FALLBACK_HOST_2`, `RB_BROKER_PORT`, `RB_MQTT_TOPIC_PREFIX`, `RB_MQTT_TELEMETRY_PERIOD_MS` |

How to change values (menuconfig or a file): [setup.md](setup.md#changing-settings).
Django settings are environment variables: [`django/README.md`](../django/README.md#configuration-environment-variables).

Regenerate this file after editing the Kconfig:

```bash
python3 tools/diagnostics/kconfig_doc.py > docs/configuration.md.new && \
  sed -n '/^## Quick index/,$p' docs/configuration.md >> docs/configuration.md.new && \
  mv docs/configuration.md.new docs/configuration.md
```
