Antonio-1110/RB4107_AY2627/docs/demo_vs_deployment.md

# Demo versus deployment

This project is a **demo**. This page keeps track of the gap to a real
deployment: what the demo deliberately leaves out, why that is fine for a demo,
and what a deployment would need. Update it when something changes. It is also
the list to draw on for the final presentation.

How to read the status: **Demo** = what the demo does today. **Deployment** =
what a real installation would need. *Checked* means I looked at the code or
measured it; *not checked* means it is an assumption.

## Information security (out of scope for the project; mention in the presentation)

| Topic | Demo | Deployment | Evidence |
|---|---|---|---|
| MQTT broker access | anonymous on the LAN (`allow_anonymous true`) | username/password and TLS | *checked*: `tools/mqtt/mosquitto.conf` |
| Dashboard API | no login; `csrf_exempt` on every command endpoint | authentication and authorisation per operator | *checked*: `django/rb4107_backend/urls.py`, `ingest/views.py` |
| Remote **reset** of a latched shutdown | any dashboard user can restore the gas | reset only at the stall (physical button), or an authenticated and logged operator action | *checked*: [remote_reset.md](remote_reset.md) |
| Remote safety settings (presence filter, timers, cooking temperature, cookware) | accepted within wide limits, so they can be set to weaken the protection | hard floors and ceilings on the S3 that the dashboard can't override; settings may only make things stricter without a physical key | *checked*: limits in `rb_ctrl_cmd.h` (warning/shutdown up to 1 h, cooking temperature up to 300 °C) |
| ESP-NOW between nodes and controller | unencrypted and unauthenticated (CRC only) | ESP-NOW encryption (PMK/LMK) or a message authentication code, plus replay protection | *checked*: `.encrypt = false` in `rb_espnow.c` |
| "Developer mode" on the dashboard | cosmetic: it hides the tools, it does not lock the API | server-side permission on the tuning endpoints | *checked*: [dashboard.md](dashboard.md#stall-page) |
| Personal data | presence of staff is logged | retention and access rules for presence and thermal data | retention exists (see Data); policy *not checked* |

## Safety hardware and fail-safe behaviour

| Topic | Demo | Deployment | Evidence |
|---|---|---|---|
| Relay polarity | de-energise to shut down: a controller with no power also cuts the supply | keep, and use a valve that is closed when unpowered | *checked*: `RB_SHUTDOWN_POLARITY` default in the Kconfig |
| Hung (not crashed) safety task | nothing ties it to the relay; the relay stays energised | a hardware or task watchdog that de-energises the relay if the safety loop stops | *checked*: no such watchdog found in the controller |
| Relay state during boot | released (appliance powered) is the default; marked an open question | decide and test the safe state | *checked*: `RB_SHUTDOWN_BOOT_STATE` |
| Reboot while a timeline is running | the timeline starts over from IDLE | keep the unattended time across a reboot, or treat a reboot with a hot stove as already unattended | *checked*: state is RAM only |
| Certification | none | a certified valve and a documented fail-closed design, reviewed by whoever signs off on the safety case | *not checked* (standards not looked up) |

## How long is too long? (unattended time limits)

| Topic | Demo | Deployment | Evidence |
|---|---|---|---|
| Time from leaving to buzzer and shutdown | **five temperature tiers** (built): buzzer 150 / 120 / 90 / 60 / 30 s from below 100 / 100 / 150 / 200 / 250 °C, shutdown twice the buzzer; a rising pan gets the tier it reaches within that tier's buzzer time; a falling pan holds a due step for up to 90 s; a baseline, anchored on 30 s of buzzer at the smoke point | tier values tuned on real camera readings of hot oil, per stove type (gas heats faster than the electric coil NIST used), and per camera under-read of shiny cookware | NIST TN 2133 (electric coil, corn oil, 9.7-26 cm pans, from cold): time to auto-ignition = 460 s + 3.9 s per gram of oil (50-150 g: 11 to 17 min); the last stage, smoking to ignition, lasts only 30-60 s; pan bottom 330 °C = start of the transition, 392 °C = ignition ([report](https://nvlpubs.nist.gov/nistpubs/TechnicalNotes/NIST.TN.2133.pdf)). Gas burners were not tested there and heat faster; a pan already hot when the cook leaves has far less than 11 min left |
| Cooking temperature | 50 °C on, 47 °C off, plus direction (see [the cooking judgment](safety_state_machine.md#cooking-judgment-is-heat-still-going-in)): detects "someone is cooking", not a hazard | separate hazard tiers above it (smoke point about 190-270 °C by oil, flash about 300-330 °C, auto-ignition about 390 °C); bare shiny metal may read low (emissivity, not measured here) and the camera tops out at 300 °C (datasheet) | placeholders *checked*; oil figures from [Culinary Lore](https://culinarylore.com/food-science:kitchen-fire-safety-when-does-cooking-oil-catch-fire) and NIST |

## Sensing and the cooking judgment

| Topic | Demo | Deployment | Evidence |
|---|---|---|---|
| Cooking temperature | 50 °C on, 47 °C off, 60 °C for a falling pan, placeholders | measured on the real cookware and stove ([issue #21](https://github.com/Antonio-1110/RB4107_AY2627/issues/21)); shiny pans read far too cold on infrared | placeholders *checked*; emissivity from [Stella Culinary](https://mobile.stellaculinary.com/node/3643) and [America's Test Kitchen](https://www.americastestkitchen.com/taste_tests/2452-infrared-thermometers) |
| Cookware time constants | estimates from typical mass and heat capacity; the profile must roughly match the pans on the stove | measured cool-down curves for the stall's actual cookware | estimates, *not measured*; simulated in `tools/diagnostics/cooling_sweep.c` and `cooling_delay.c` |
| Several burners | one trend for the hottest pixel of the whole frame, so one pan can hide another | track each burner separately | design limit, *checked* in `safety.c` |
| Spikes in the hottest pixel (a hand, steam) | the trend is a plain least-squares fit, so a spike skews it | median filter before the fit | design limit, *checked* |
| Radar directionality | no angle from the radar: range, gates and thresholds only; the C4002 listing says 120° × 120°, rear sensitivity unknown; no metal enclosure yet | an enclosure with a metal back and absorber, tested with the live view; sensor placed so the people to ignore are farther than the cook | listings and datasheets only, *not measured*; procedure in [c4002_tuning.md](c4002_tuning.md#detections-behind-or-beside-the-sensor) |
| Passers-by and the unattended clock | a pass pauses the clock (budget 30 s, at most 25 % of the shutdown time), 5 s of presence at the stove cancels the timeline; at the stove = every working radar sees someone; nothing yet tells a walker from a cook except duration, and a person lingering where every radar sees them still cancels it | recorded real walk-bys and cook visits to tune the 5 s and the budget, and per-radar rules on moving/stationary state and distance; a second independent signal | *checked* in tests on simulated pauses; *not measured* on real people; [safety_state_machine.md](safety_state_machine.md#who-is-at-the-stove-and-the-pause) |
| Radar state and distance rules | episodes from none/moving/stationary and distance; verdict shown, not enforced by default (mode and numbers adjustable from the dashboard) | thresholds measured on real walkers, cooks and cookware; a zone per stove | *placeholder, untuned* |
| Presence | two radars OR-ed; a false target on either keeps the gas on ([issue #20](https://github.com/Antonio-1110/RB4107_AY2627/issues/20)) | a second, independent presence vote (the thermal camera sees warm bodies), zone and range tuning | radar OR *checked*; thermal vote *not built* |
| A lost sensor | a flag on the dashboard only; no local sound or light | a local indication that protection is degraded | *checked*: buzzer patterns exist for warning, shutdown and fault only |
| Kitchen environment | bench setup | grease, steam, heat and cleaning on the lens and the radar housing | *not checked* |

## Data and storage

| Topic | Demo | Deployment | Evidence |
|---|---|---|---|
| Database growth | `tools/run_dev.sh` erases the database every time it stops, so it never builds up | a retention job (built, defaults below) and sized disk | *measured*: about 0.86 GB per day per controller without pruning ([dashboard.md](dashboard.md#storage)) |
| Raw radar stream for the live view | on at 250 ms (about 320 MB per day if stored) | set `RB_C4002_LIVE_PERIOD_MS=0` on the presence nodes: it is only used by the Tuning radar view | *measured*; see below |
| Retention | built and tested; first run one minute after the subscriber starts | confirm the numbers with whoever owns the data | `ingest/retention.py` |

`RB_C4002_LIVE_PERIOD_MS` is a presence-node menuconfig option (*Sensor node,
C4002 presence sensor, "Send raw C4002 results for the dashboard's live view
every (ms)"*, default 250). It sets how often the node sends each raw radar
result to the controller, which publishes it over MQTT for the Tuning radar view.
Results can't come faster than the radar's report period (0.5 s), so the real
rate is about 2 per second per radar. **0 turns the stream off**: the live view
then stays empty, and the safety path is not affected. For the demo, keep the
default if you want to show the live radar view.

## Operations and testing

| Topic | Demo | Deployment | Evidence |
|---|---|---|---|
| Automated tests | host tests run by hand (safety, protocol, JSON, Django); the ESP-IDF unit-test app has to be built with ESP-IDF | CI that runs the host tests on every push | *checked*: no `.github` folder; the unit-test app did not compile for a while before it was noticed |
| Adding a node | node IDs by MAC address in `sdkconfig`, reflash to add one | provisioning without a rebuild | *checked*: `presence_node/sdkconfig.defaults` |
| Dashboard and flashed settings | settings sent from the dashboard may differ from the flashed defaults; the presence filter is lost on reboot | one place that shows what is running and where it came from | partly built (the telemetry reports the source of each setting) |
| Hardware-in-the-loop test | none | a repeatable end-to-end test with real sensors and a real shut-off | *not built* |
| Alerts to staff | Telegram message on buzzer and shutdown, with an Acknowledge button that records who responded, sent from Django on the Mac ([telegram_alerts.md](telegram_alerts.md)); nothing if the Mac or internet is down | SMS for the critical alert, from a sender ID registered in Singapore's SMS Sender ID Registry (needs the operator's UEN, S$500 setup plus S$200 a year per ID; unregistered senders show as "Likely-SCAM"), sent from a server that is always on | *checked*: [SGNIC registry](https://prod.sgnic.sg/smsregistry); SMS *not built* |

## Demo notes (things to know when presenting)

- **The timers depend on the temperature of the pan, and on how fast it rises.**
  Five tiers: a simmer (below 100 °C) gets the base times below, then 120 / 90 / 60 /
  30 s to the buzzer from 100 / 150 / 200 / 250 °C, the shutdown at twice that. A pan
  rising fast gets the tier it is heading for. The dashboard's "hot_pan" demo scenario
  shows tier 4. The tier values are a baseline.
- **The base timers are 2.5 min to the buzzer and 5 min to the shutdown**
  (`RB_SAFETY_WARNING_TIMEOUT_S` and `RB_SAFETY_SHUTDOWN_TIMEOUT_S`). The cooking judgment needs about 1-2 minutes of temperature
  history, so the buzzer has to come later than that for the demo to show the
  timers behaving correctly for the situation. Both can be changed from the
  dashboard (Tuning, Safety); the controller saves them.
- **The diagnostic console's accelerated test timers still don't mix with the
  cooking judgment**: with a warning time of a few seconds the buzzer fires
  before the trend can engage. A lowered flame versus an off burner needs
  several minutes on real hardware; the dashboard's "cooling" demo scenario
  (`simulate_fleet`) shows the held state without waiting.
- **After any hold the buzzer sounds for at least 30 s before a shutdown**, so a
  demo of a held timeline ends with a visible warning first.
- **The cookware profile and the cooking temperature are saved on the
  controller**, so a profile set at rehearsal is still there on stage.
- **`tools/run_dev.sh` wipes the database on stop**, which is what you want
  for a clean demo and not what you want if you need yesterday's data.
