Antonio-1110/RB4107_AY2627/docs/protocol.md

# RB4107 ESP-NOW protocol (v3)

Sensor nodes (ESP32-C6) → controller (ESP32-S3), plus C4002 tuning messages
between the controller and the presence nodes ([c4002_tuning.md](c4002_tuning.md)). The implementation is in
[`firmware/components/rb_protocol`](../firmware/components/rb_protocol), and
every firmware builds that same code.

The system has three nodes, each with one sensor:

| Node | Firmware | Default node ID | Role | Sends |
|---|---|---|---|---|
| presence node A | `presence_node` | 1 | presence | PRESENCE_DATA, HEARTBEAT, SENSOR_FAULT |
| presence node B | `presence_node` (built with `sdkconfig.node_b`) | 2 | presence | PRESENCE_DATA, HEARTBEAT, SENSOR_FAULT |
| thermal node | `thermal_node` | 3 | thermal | THERMAL_DATA, HEARTBEAT, SENSOR_FAULT, THERMAL_FRAME |
| controller | `controller` | 0 | controller | C4002_CONFIG, THERMAL_CONFIG |

The controller is the one sender that isn't a node, so its node ID is 0.
There is no separate valve node: the controller drives the shutdown output
itself (digital output 1, energised while it is safe). Message types 5 and 6
(the old VALVE_COMMAND and VALVE_STATUS) and role 3 (valve) are retired: the
controller rejects them as unknown, and they must not be reused.

Version 1 carried presence and thermal data in one SENSOR_DATA packet from a
single node. Version 2 splits them, and adds the sender's role to every
packet.

## Design rules

- **Explicit serialisation.** Fields are written one by one in little-endian
  order. C structs are never copied onto the wire, so compiler padding and
  alignment can't change the format.
- **Versioned.** Any change to the layout bumps `RB_PROTOCOL_VERSION`. The
  receiver rejects every other version.
- **Self-checking.** Each packet has a fixed length per message type and ends
  with a CRC-16/CCITT-FALSE (poly `0x1021`, init `0xFFFF`) over every earlier
  byte. The receiver also checks the magic, version, type, role, exact length
  and node ID.
- **Role-checked.** A message must match its sender's role (a thermal
  node can't send PRESENCE_DATA, and only the controller can send
  C4002_CONFIG). The controller also checks that the role
  matches what it expects for that node ID, so a board flashed with the wrong
  firmware or ID is dropped and reported (`espnow_unknown_node`), never
  mistaken for another sensor.
- **Unknown is not zero.** Missing values have sentinels (below) and decode
  to `NAN`, never to a plausible number.
- **Size-checked at compile time.** `_Static_assert`s keep every packet at or
  under the ESP-NOW v1 limit of 250 bytes. The largest packet is
  THERMAL_FRAME at 224 bytes.

## Common header (17 bytes)

| Offset | Size | Field | Notes |
|---|---|---|---|
| 0 | 2 | magic | `0x52 0x42` ("RB") |
| 2 | 1 | protocol_version | `3` |
| 3 | 1 | message_type | `1` PRESENCE_DATA, `2` THERMAL_DATA, `3` HEARTBEAT, `4` SENSOR_FAULT, (`5` and `6` retired), `7` C4002_CONFIG, `8` C4002_CONFIG_ACK, `9` C4002_LIVE, `10` THERMAL_FRAME, `11` THERMAL_CONFIG |
| 4 | 1 | node_role | `1` presence, `2` thermal, (`3` retired), `4` controller |
| 5 | 4 | node_id | `CONFIG_RB_NODE_ID` of the sender |
| 9 | 4 | sequence | +1 for every packet the node sends (all types except THERMAL_FRAME, which carries its frame number here) |
| 13 | 4 | uptime_ms | node monotonic time; lets the receiver spot a node reboot |

Every packet ends with a 2-byte CRC.

## PRESENCE_DATA (type 1, 26 bytes total)

Sent at once when `valid` or `presence detected` changes (the node checks every
50 ms), and every `RB_NODE_DATA_PERIOD_MS` (default 500 ms) as a refresh. The
reading is the radar's raw state: the radar holds nothing back (disappear delay
0, lock time 0.2 s) and the controller does all the debouncing.

| Offset | Size | Field | Encoding |
|---|---|---|---|
| 17 | 1 | flags | bit0 valid, bit1 presence detected, bit2 moving, bit3 stationary |
| 18 | 2 | distance | cm, `0xFFFF` = unknown |
| 20 | 4 | timestamp | node ms of the reading |
| 24 | 2 | CRC | |

## THERMAL_DATA (type 2, 38 bytes total)

| Offset | Size | Field | Encoding |
|---|---|---|---|
| 17 | 1 | flags | bit0 valid |
| 18 | 2 | max temp | int16, 0.01 °C |
| 20 | 2 | min temp | int16, 0.01 °C |
| 22 | 2 | mean temp | int16, 0.01 °C |
| 24 | 2 | room temp | int16, 0.01 °C: 10th percentile of the valid pixels (added in v3) |
| 26 | 2 | hot-region temp | int16, 0.01 °C |
| 28 | 2 | temp rate | int16, 0.01 °C/min |
| 30 | 2 | pixels above threshold | uint16 |
| 32 | 4 | timestamp | node ms of the frame |
| 36 | 2 | CRC | |

The room temperature (v3) is what the controller's cooling judgment compares
the pan with (see [safety_rules.md](safety_rules.md), D2 and D5). Version 3
changed this layout, so every board needs reflashing together.

Temperatures use `INT16_MIN` (`0x8000`) for "unknown" and saturate at
±327.67 °C. The safety logic only ever uses these values; the picture
itself travels separately, for display, as THERMAL_FRAME.

## HEARTBEAT (type 3, 29 bytes total)

Sent every `CONFIG_RB_NODE_HEARTBEAT_PERIOD_MS`, including when the sensor
has failed, so the controller can tell a dead node from a node with a dead
sensor.

| Offset | Size | Field |
|---|---|---|
| 17 | 2 | active sensor fault flags |
| 19 | 4 | ESP-NOW sends acknowledged |
| 23 | 4 | ESP-NOW sends failed |
| 27 | 2 | CRC |

## SENSOR_FAULT (type 4, 27 bytes total)

Sent right away whenever a fault flag changes, whether it is raised or
cleared.

| Offset | Size | Field |
|---|---|---|
| 17 | 2 | active sensor fault flags |
| 19 | 2 | flags that changed |
| 21 | 4 | detail (int32 driver error code, 0 if none) |
| 25 | 2 | CRC |

### Sensor fault flags

| Bit | Name | Meaning | Sent by |
|---|---|---|---|
| 0 | `C4002_NO_DATA` | no report from the C4002 within its stale timeout | presence nodes |
| 1 | `C4002_INVALID` | reports arrive but fail validation | presence nodes |
| 2 | `MLX_NO_DATA` | MLX90640 missing or failing to deliver frames | thermal node |
| 3 | `MLX_INVALID` | frames arrive but fail validation | thermal node |

## C4002 parameters block (70 bytes)

Used by both tuning messages. Field meanings and limits:
[c4002_tuning.md](c4002_tuning.md).

| Offset | Size | Field |
|---|---|---|
| 0 | 1 | report period (0.1 s) |
| 1 | 2 | range min (cm) |
| 3 | 2 | range max (cm) |
| 5 | 1 | resolution: `0` 80 cm, `1` 20 cm |
| 6 | 1 | motion sensitivity: `0` low, `1` mid, `2` high, `3` custom |
| 7 | 1 | presence sensitivity (same codes) |
| 8 | 2 | disappear delay (s) |
| 10 | 1 | lock time (0.1 s) |
| 11 | 4 | motion gate mask (bit *i* = gate *i* on) |
| 15 | 4 | presence gate mask |
| 19 | 1 | thresholds known: bit0 motion, bit1 presence |
| 20 | 25 | motion thresholds, one per gate |
| 45 | 25 | presence thresholds |

## C4002_CONFIG (type 7, 102 bytes total)

Controller → one presence node, sent to the MAC the controller learned from
that node's packets. Header node_id is 0, role `4` controller. The node only
accepts it from `RB_NODE_CONTROLLER_MAC`.

| Offset | Size | Field |
|---|---|---|
| 17 | 4 | target node ID |
| 21 | 2 | request ID (echoed in the ACK) |
| 23 | 1 | action: `1` apply, `2` calibrate, `3` read, `4` reset |
| 24 | 2 | field mask (apply): which parameters to change, see `RB_C4002_F_*` |
| 26 | 2 | calibration delay (s) |
| 28 | 2 | calibration duration (s) |
| 30 | 70 | parameters block |
| 100 | 2 | CRC |

## C4002_CONFIG_ACK (type 8, 96 bytes total)

Presence node → controller, after every C4002_CONFIG, and again when a
calibration finishes. Uses the node's normal sequence counter.

| Offset | Size | Field |
|---|---|---|
| 17 | 2 | request ID (0 = the controller's automatic read) |
| 19 | 1 | action answered |
| 20 | 1 | result: `0` ok, `1` invalid, `2` sensor error |
| 21 | 2 | calibration seconds remaining (0 = none running) |
| 23 | 1 | settings saved in NVS (0/1) |
| 24 | 70 | parameters block: the settings now in use |
| 94 | 2 | CRC |

## C4002_LIVE (type 9, 46 bytes total)

Presence node → controller: the C4002's newest detection result, unfiltered,
at most every `RB_C4002_LIVE_PERIOD_MS` (default 250 ms), only when a new one
came in. For the dashboard's live radar view; the safety logic ignores it and
keeps using PRESENCE_DATA. Uses the node's normal sequence counter.

| Offset | Size | Field |
|---|---|---|
| 17 | 1 | target state: `0` none, `1` stationary, `2` moving |
| 18 | 1 | resolution in use: `0` 80 cm gates, `1` 20 cm gates |
| 19 | 4 | stationary gate mask (bit *i* = gate *i*) |
| 23 | 2 | hold countdown (s) |
| 25 | 2 | stationary target distance (cm) |
| 27 | 1 | stationary target energy (0–99) |
| 28 | 2 | moving target distance (cm) |
| 30 | 2 | moving target speed (cm/s, signed) |
| 32 | 1 | moving target energy (0–99) |
| 33 | 1 | direction: `0` away, `1` none, `2` approaching |
| 34 | 2 | light (0.1 lux) |
| 36 | 2 | calibration seconds remaining |
| 38 | 2 | age of the result when sent (ms) |
| 40 | 4 | results received from the sensor since boot |
| 44 | 2 | CRC |

Messages 7 to 10 were added the same way.

## THERMAL_FRAME (type 10, 224 bytes total)

The thermal camera's whole 32×24 picture, for the dashboard heat map. It is
**display only**: the controller handles it outside the safety task (it never
enters the receive queue), and nothing in the safety logic reads it. Losing
one costs a picture, nothing else.

Each picture is sent every `RB_THERMAL_HEATMAP_PERIOD_MS` (default 3 s) as 4
pieces of 6 rows, one piece per 50 ms link tick, so the regular packets go out
in between. The header's `sequence` holds the **frame number** (+1 per
picture), the same in all 4 pieces. Frame pieces don't advance the node's
packet sequence, so the controller's missed-packet count keeps meaning "lost
safety packets".

| Offset | Size | Field | Encoding |
|---|---|---|---|
| 17 | 1 | piece | 0 – 3; piece n holds rows 6n … 6n+5 |
| 18 | 1 | pieces | always 4 |
| 19 | 2 | base | int16, 0.01 °C: temperature of pixel value 0 |
| 21 | 2 | step | uint16, 0.01 °C per pixel value (≥ 1) |
| 23 | 4 | timestamp | node ms of the frame |
| 27 | 2 | hot threshold | int16, 0.01 °C: the threshold the node uses now (`RB_THERMAL_HOT_PIXEL_THRESHOLD_DC`, or the dashboard's, see THERMAL_CONFIG) |
| 29 | 1 | hot-region radius | the node's `RB_THERMAL_HOT_REGION_RADIUS` (pixels) |
| 30 | 192 | pixels | 1 byte per pixel, row by row, 32 per row |
| 222 | 2 | CRC | |

## THERMAL_CONFIG (type 11, 28 bytes total)

Controller → thermal node: the cooking temperature set on the dashboard, used
by the node as its hot-pixel threshold
([remote_reset.md](remote_reset.md#cooking-temperature)). The controller always
sends action `1`. Only the controller
role may send it. The node checks that it came from `RB_NODE_CONTROLLER_MAC`
and names its own node ID, uses the value from the next frame and saves it in
NVS. There is no answer message: the threshold in use is in every
THERMAL_FRAME piece (offset 27).

| Offset | Size | Field | Encoding |
|---|---|---|---|
| 17 | 4 | target node ID | the thermal node's `RB_NODE_ID` |
| 21 | 2 | request ID | the dashboard's, for the logs |
| 23 | 1 | action | `1` set (use and save the threshold), `2` defaults (erase the saved one, back to menuconfig) |
| 24 | 2 | hot threshold | int16, 0.01 °C (set only; the node accepts -40.00 – 300.00 °C) |
| 26 | 2 | CRC | |

Added without a version bump, like messages 5 to 10: the presence and thermal
nodes don't need reflashing.

The threshold and radius let the dashboard draw what the node's own hot-pixel
count and hot-region temperature are based on.

Pixel value `v` means `base + v × step`; `255` means the pixel had no valid
reading (non-finite or outside `RB_THERMAL_VALID_MIN/MAX_DC`). The node fits
the range to each picture: base is the coldest pixel and the step the smallest
that reaches the hottest in 254 levels, but never finer than 0.1 °C. A
kitchen scene from 20 to 200 °C therefore has steps of about 0.7 °C; a room
with nothing hot has 0.1 °C steps.

The controller collects the pieces and forwards a picture only when all 4
arrived with the same frame number, base, step and timestamp. An incomplete
picture is dropped and replaced by the next one. Only the configured thermal
node's pictures are kept (`RB_CTRL_THERMAL_NODE_ID`).

Why 4 pieces instead of one big packet: ESP-IDF 6.1 also supports ESP-NOW v2
packets of up to 1470 bytes, which would fit the whole picture. The 250-byte
pieces were kept because every packet then stays within the v1 limit the rest
of the protocol is built on, and a short packet is less likely to be lost
than one four times longer. The cost is about 90 bytes of extra headers per
picture, which is negligible at one picture every few seconds.

## Edge decisions (not decided yet)

Today every node sends its reading and the controller decides (combining the
two radars, then the safety state machine). If the nodes later decide
something themselves (e.g. a presence node debouncing its own radar), that is
a new field or message type and a protocol version bump. The controller's
per-node tracking, health monitoring and faults stay the same.
