Antonio-1110/RB4107_AY2627/firmware/testing/c4002/README.md

# Test: C4002 presence sensor

> **Test only, not part of the running system.** It checks the C4002 radar on its own. Flashing it
> replaces the system firmware on that board. To run the system, flash
> [`presence_node`](../../presence_node) on the two presence C6 boards,
> [`thermal_node`](../../thermal_node) on the thermal C6 board and
> [`controller`](../../controller) on the S3.

Target: **DFRobot DFR1117 (ESP32-C6 mini)** + **DFRobot C4002 (SEN0691)**.

## Interface

The C4002 talks over **UART at 115200 8N1** using DFRobot's framed protocol.
The frame layout comes from the official
[DFRobot_C4002](https://github.com/DFRobot/DFRobot_C4002) library and is
documented in `components/c4002/include/c4002_proto.h`. An optional **OUT**
pin also gives a digital "target present" level.

| C4002 | DFR1117 (menuconfig default) |
|---|---|
| TX | `RB_C4002_RX_GPIO` = IO4 (header P3 pin 3) |
| RX | `RB_C4002_TX_GPIO` = IO5 (header P3 pin 4) |
| OUT (optional) | `RB_C4002_OUT_GPIO` = not wired |
| VCC / GND | 5 V (header P4 pin 3, VUSB: only live on USB power) / GND |

IO4 (RX) and IO5 (TX) were confirmed on the bench. If the log shows
`frames=0`, check the wiring first, then try swapping the two values.
IO16/IO17 (header P4, labelled TX/RX) would also work, but they are UART0,
where the ROM prints its boot messages. Set the pins in `idf.py menuconfig` →
*RB4107 configuration* → *Sensor node* → *C4002 presence sensor*, or in a file
(see [`docs/configuration.md`](../../../docs/configuration.md)).

## What the driver provides

- `presence_reading_t`: `valid`, `presence_detected`, `moving_target`,
  `stationary_target`, `distance_m`, `timestamp_ms`. The C4002 reports all of them.
- Validity: checksum and length errors are counted and dropped, unknown
  target states or impossible distances make a reading invalid, and a
  reading goes **invalid** after `RB_C4002_STALE_TIMEOUT_MS` without a report.
  Invalid never turns into "no presence".
- Configurable detection parameters: report period, range, gate resolution,
  motion/static sensitivity group, target-disappear delay, and environment
  calibration at boot.

## Running

```bash
idf.py build flash monitor
```

The log shows a line on every state change (`NONE -> STATIONARY at 1.20 m`) and,
every 5 s, the raw report plus parser statistics.

## Investigating false static-presence detections

Things to try, in order. Record what you observe for each.

0. **Make sure the readings are new.** In DFRobot's Arduino driver,
   `getNoteInfo()` declares its return value without initialising it
   (`sRetResult_t ret;`). When no frame has arrived, `noteType` is whatever
   was left on the stack, often `eResult` from the previous call. So the
   `getAllResults` example keeps printing the *last* result again and again,
   as if the sensor kept reporting the same thing. This driver only takes a
   reading from a complete frame that passed its checksum. Every reading
   has an age, and a reading older than `RB_C4002_STALE_TIMEOUT_MS` is
   invalid. In this project's log, `age=` must stay below the report period
   and `frames=` must keep going up. If `frames=` stops, the sensor has
   stopped sending (check wiring, baud rate, report period).
1. **Parse the report correctly.** DFRobot's Arduino driver `memcpy()`s the
   18-byte result into a naturally aligned struct, which garbles every field
   after `target_state` on 32-bit MCUs (the Python driver parses it packed).
   This driver parses it packed. If earlier tests used the Arduino driver,
   their distance and energy values were wrong.
2. **Hold time.** The `hold=` countdown in the summary should stay at 0: a long
   hold looks like someone "still being there". The disappear delay is fixed at
   0 and the lock time at 0.2 s in the node firmware; the S3 does the debouncing.
3. **Range.** Reduce `RB_C4002_RANGE_MAX_CM` to the cooking area, so reflections
   from far walls or other rooms drop out.
4. **Sensitivity.** Lower `RB_C4002_PRESENCE_SENSITIVITY`.
5. **Environment calibration.** Enable `RB_C4002_ENV_CALIBRATION_AT_BOOT` and
   leave the room empty for the calibration period.
6. **Which gates fire.** `gates=` in the summary is a bitmask of the distance
   gates holding a static target. Fixed gates firing with the room empty point
   to a static reflector (fridge, extractor fan, metal pans).
