Antonio-1110/RB4107_AY2627/firmware/testing/rtc/README.md

# Test: RTC / time

> **Test only, not part of the running system.** It checks the real-time clock on its own. Flashing it
> replaces the system firmware on that board. To run the system, flash
> [`presence_node`](../../presence_node) on the two presence C6 boards,
> [`thermal_node`](../../thermal_node) on the thermal C6 board and
> [`controller`](../../controller) on the S3.

Target: **Waveshare ESP32-S3-POE-ETH-8DI-8DO** (PCF85063 RTC at `0x51`).

There are two separate notions of time:

| | Monotonic | Wall clock |
|---|---|---|
| API | `rb_time_mono_ms()` (`components/rb_time`) | `rb_wallclock_iso8601()` (`components/rb_wallclock`) |
| Source | `esp_timer` | PCF85063 at boot, then SNTP (written back to the RTC) |
| Used for | unattended/warning timers, sensor and communication timeouts, state durations | event timestamps, logs, MQTT messages |
| When wrong | can't be wrong (never jumps) | timestamps are missing or wrong, and safety is unaffected |

The RTC stores **UTC**. `RB_TIME_TZ` (default `SGT-8`) only affects how
timestamps are formatted. An event's timestamp is worked out from its
monotonic time, so events queued during a network outage still get correct
wall-clock times.

## Persistence test

1. Enable `RB_TIME_SET_RTC_FROM_BUILD` (or run a networked build so SNTP sets it).
2. Flash and check the RTC reads `ok`.
3. Power the board off for a few minutes, then on again.
4. The boot log should say `wall clock restored from PCF85063` with the correct time.
