Antonio-1110/RB4107_AY2627/firmware/components/rb_protocol/src/rb_protocol.c

#include "rb_protocol.h"

#include <math.h>
#include <string.h>

#define DIST_UNKNOWN 0xFFFFu
#define CENTI_UNKNOWN INT16_MIN

/* PRESENCE_DATA flags. */
enum {
    FLAG_PRESENCE_VALID = 1u << 0,
    FLAG_PRESENCE_DETECTED = 1u << 1,
    FLAG_PRESENCE_MOVING = 1u << 2,
    FLAG_PRESENCE_STATIONARY = 1u << 3,
};

/* THERMAL_DATA flags. */
enum {
    FLAG_THERMAL_VALID = 1u << 0,
};

/* ---- little-endian writer / reader ---- */

typedef struct {
    uint8_t *p;
    size_t n;
} writer_t;

static void put_u8(writer_t *w, uint8_t v)
{
    w->p[w->n++] = v;
}

static void put_u16(writer_t *w, uint16_t v)
{
    put_u8(w, (uint8_t)(v & 0xFF));
    put_u8(w, (uint8_t)(v >> 8));
}

static void put_u32(writer_t *w, uint32_t v)
{
    put_u16(w, (uint16_t)(v & 0xFFFF));
    put_u16(w, (uint16_t)(v >> 16));
}

typedef struct {
    const uint8_t *p;
    size_t n;
} reader_t;

static uint8_t get_u8(reader_t *r)
{
    return r->p[r->n++];
}

static uint16_t get_u16(reader_t *r)
{
    uint16_t lo = get_u8(r);
    return (uint16_t)(lo | (get_u8(r) << 8));
}

static uint32_t get_u32(reader_t *r)
{
    uint32_t lo = get_u16(r);
    return lo | ((uint32_t)get_u16(r) << 16);
}

/* ---- fixed-point helpers ---- */

static int16_t to_centi(float v)
{
    if (!isfinite(v)) {
        return CENTI_UNKNOWN;
    }
    float c = roundf(v * 100.0f);
    if (c > INT16_MAX) {
        return INT16_MAX;
    }
    if (c <= INT16_MIN) {
        return INT16_MIN + 1; /* INT16_MIN is reserved for "unknown" */
    }
    return (int16_t)c;
}

static float from_centi(int16_t v)
{
    return v == CENTI_UNKNOWN ? NAN : (float)v / 100.0f;
}

static uint16_t to_cm(float metres)
{
    if (!isfinite(metres) || metres < 0.0f) {
        return DIST_UNKNOWN;
    }
    float cm = roundf(metres * 100.0f);
    return cm >= (float)DIST_UNKNOWN ? (uint16_t)(DIST_UNKNOWN - 1) : (uint16_t)cm;
}

static float from_cm(uint16_t cm)
{
    return cm == DIST_UNKNOWN ? NAN : (float)cm / 100.0f;
}

static size_t packet_len(rb_msg_type_t type)
{
    switch (type) {
    case RB_MSG_PRESENCE_DATA: return RB_PKT_PRESENCE_DATA_LEN;
    case RB_MSG_THERMAL_DATA: return RB_PKT_THERMAL_DATA_LEN;
    case RB_MSG_HEARTBEAT: return RB_PKT_HEARTBEAT_LEN;
    case RB_MSG_SENSOR_FAULT: return RB_PKT_SENSOR_FAULT_LEN;
    case RB_MSG_C4002_CONFIG: return RB_PKT_C4002_CONFIG_LEN;
    case RB_MSG_C4002_CONFIG_ACK: return RB_PKT_C4002_CONFIG_ACK_LEN;
    case RB_MSG_C4002_LIVE: return RB_PKT_C4002_LIVE_LEN;
    case RB_MSG_THERMAL_CONFIG: return RB_PKT_THERMAL_CONFIG_LEN;
    default: return 0;
    }
}

/* Each message may only come from a sender of the matching role. */
static bool role_ok(rb_node_role_t role, rb_msg_type_t type)
{
    switch (role) {
    case RB_NODE_ROLE_PRESENCE:
        return type == RB_MSG_PRESENCE_DATA || type == RB_MSG_HEARTBEAT || type == RB_MSG_SENSOR_FAULT ||
               type == RB_MSG_C4002_CONFIG_ACK || type == RB_MSG_C4002_LIVE;
    case RB_NODE_ROLE_THERMAL:
        return type == RB_MSG_THERMAL_DATA || type == RB_MSG_HEARTBEAT || type == RB_MSG_SENSOR_FAULT ||
               type == RB_MSG_THERMAL_FRAME;
    case RB_NODE_ROLE_CONTROLLER:
        return type == RB_MSG_C4002_CONFIG || type == RB_MSG_THERMAL_CONFIG;
    default: return false;
    }
}

static void put_params(writer_t *w, const rb_c4002_params_t *p)
{
    put_u8(w, p->report_period_ds);
    put_u16(w, p->range_min_cm);
    put_u16(w, p->range_max_cm);
    put_u8(w, p->resolution);
    put_u8(w, p->motion_sensitivity);
    put_u8(w, p->presence_sensitivity);
    put_u16(w, p->disappear_delay_s);
    put_u8(w, p->lock_time_ds);
    put_u32(w, p->motion_gate_mask);
    put_u32(w, p->presence_gate_mask);
    put_u8(w, p->thresholds_known);
    for (unsigned i = 0; i < RB_C4002_MAX_GATES; i++) {
        put_u8(w, p->motion_thresholds[i]);
    }
    for (unsigned i = 0; i < RB_C4002_MAX_GATES; i++) {
        put_u8(w, p->presence_thresholds[i]);
    }
}

static void get_params(reader_t *r, rb_c4002_params_t *p)
{
    p->report_period_ds = get_u8(r);
    p->range_min_cm = get_u16(r);
    p->range_max_cm = get_u16(r);
    p->resolution = get_u8(r);
    p->motion_sensitivity = get_u8(r);
    p->presence_sensitivity = get_u8(r);
    p->disappear_delay_s = get_u16(r);
    p->lock_time_ds = get_u8(r);
    p->motion_gate_mask = get_u32(r);
    p->presence_gate_mask = get_u32(r);
    p->thresholds_known = get_u8(r);
    for (unsigned i = 0; i < RB_C4002_MAX_GATES; i++) {
        p->motion_thresholds[i] = get_u8(r);
    }
    for (unsigned i = 0; i < RB_C4002_MAX_GATES; i++) {
        p->presence_thresholds[i] = get_u8(r);
    }
}

uint16_t rb_crc16(const uint8_t *data, size_t len)
{
    uint16_t crc = 0xFFFF;
    for (size_t i = 0; i < len; i++) {
        crc ^= (uint16_t)data[i] << 8;
        for (int b = 0; b < 8; b++) {
            crc = (crc & 0x8000) ? (uint16_t)((crc << 1) ^ 0x1021) : (uint16_t)(crc << 1);
        }
    }
    return crc;
}

static void put_header(writer_t *w, const rb_packet_t *pkt)
{
    put_u8(w, RB_PROTOCOL_MAGIC & 0xFF);
    put_u8(w, RB_PROTOCOL_MAGIC >> 8);
    put_u8(w, RB_PROTOCOL_VERSION);
    put_u8(w, (uint8_t)pkt->type);
    put_u8(w, (uint8_t)pkt->role);
    put_u32(w, pkt->node_id);
    put_u32(w, pkt->sequence);
    put_u32(w, pkt->uptime_ms);
}

size_t rb_protocol_encode(const rb_packet_t *pkt, uint8_t *buf, size_t buf_len)
{
    const size_t total = packet_len(pkt->type);
    if (total == 0 || buf == NULL || buf_len < total || !role_ok(pkt->role, pkt->type)) {
        return 0;
    }
    writer_t w = {.p = buf, .n = 0};
    put_header(&w, pkt);

    switch (pkt->type) {
    case RB_MSG_PRESENCE_DATA: {
        const presence_reading_t *p = &pkt->body.presence;
        uint8_t flags = 0;
        flags |= p->valid ? FLAG_PRESENCE_VALID : 0;
        flags |= p->presence_detected ? FLAG_PRESENCE_DETECTED : 0;
        flags |= p->moving_target ? FLAG_PRESENCE_MOVING : 0;
        flags |= p->stationary_target ? FLAG_PRESENCE_STATIONARY : 0;
        put_u8(&w, flags);
        put_u16(&w, to_cm(p->distance_m));
        put_u32(&w, p->timestamp_ms);
        break;
    }
    case RB_MSG_THERMAL_DATA: {
        const thermal_reading_t *t = &pkt->body.thermal;
        put_u8(&w, t->valid ? FLAG_THERMAL_VALID : 0);
        put_u16(&w, (uint16_t)to_centi(t->max_temp_c));
        put_u16(&w, (uint16_t)to_centi(t->min_temp_c));
        put_u16(&w, (uint16_t)to_centi(t->mean_temp_c));
        put_u16(&w, (uint16_t)to_centi(t->ambient_c));
        put_u16(&w, (uint16_t)to_centi(t->hot_region_temp_c));
        put_u16(&w, (uint16_t)to_centi(t->temp_rate_c_per_min));
        put_u16(&w, t->pixels_above_threshold);
        put_u32(&w, t->timestamp_ms);
        break;
    }
    case RB_MSG_HEARTBEAT:
        put_u16(&w, pkt->body.heartbeat.fault_flags);
        put_u32(&w, pkt->body.heartbeat.tx_ok);
        put_u32(&w, pkt->body.heartbeat.tx_fail);
        break;
    case RB_MSG_SENSOR_FAULT:
        put_u16(&w, pkt->body.fault.fault_flags);
        put_u16(&w, pkt->body.fault.changed_flags);
        put_u32(&w, (uint32_t)pkt->body.fault.detail);
        break;
    case RB_MSG_C4002_CONFIG: {
        const rb_c4002_config_msg_t *c = &pkt->body.c4002_config;
        put_u32(&w, c->target_node_id);
        put_u16(&w, c->request_id);
        put_u8(&w, c->action);
        put_u16(&w, c->field_mask);
        put_u16(&w, c->calib_delay_s);
        put_u16(&w, c->calib_duration_s);
        put_params(&w, &c->params);
        break;
    }
    case RB_MSG_C4002_CONFIG_ACK: {
        const rb_c4002_ack_t *a = &pkt->body.c4002_ack;
        put_u16(&w, a->request_id);
        put_u8(&w, a->action);
        put_u8(&w, a->result);
        put_u16(&w, a->calib_remaining_s);
        put_u8(&w, a->saved);
        put_params(&w, &a->params);
        break;
    }
    case RB_MSG_C4002_LIVE: {
        const rb_c4002_live_t *l = &pkt->body.c4002_live;
        put_u8(&w, l->target_state);
        put_u8(&w, l->resolution);
        put_u32(&w, l->presence_gate_mask);
        put_u16(&w, l->presence_countdown_s);
        put_u16(&w, l->presence_distance_cm);
        put_u8(&w, l->presence_energy);
        put_u16(&w, l->motion_distance_cm);
        put_u16(&w, (uint16_t)l->motion_speed_cm_s);
        put_u8(&w, l->motion_energy);
        put_u8(&w, l->motion_direction);
        put_u16(&w, l->light_dlux);
        put_u16(&w, l->calib_remaining_s);
        put_u16(&w, l->age_ms);
        put_u32(&w, l->results);
        break;
    }
    case RB_MSG_THERMAL_CONFIG: {
        const rb_thermal_config_msg_t *c = &pkt->body.thermal_config;
        put_u32(&w, c->target_node_id);
        put_u16(&w, c->request_id);
        put_u8(&w, c->action);
        put_u16(&w, (uint16_t)c->hot_threshold_centi);
        break;
    }
    default:
        break;
    }
    if (w.n + RB_CRC_LEN != total) {
        return 0; /* body layout and the RB_BODY_*_LEN constants disagree */
    }
    put_u16(&w, rb_crc16(buf, w.n));
    return w.n;
}

/*
 * Check everything but the body and read the header into out. expected_len
 * is the packet length for the type byte (0 = not a type this caller handles).
 */
static rb_decode_result_t decode_header(const uint8_t *buf, size_t len, size_t expected_len, rb_packet_t *out,
                                        reader_t *r)
{
    if (buf == NULL || len < RB_HEADER_LEN + RB_CRC_LEN) {
        return RB_DECODE_ERR_LENGTH;
    }
    if ((buf[0] | (buf[1] << 8)) != RB_PROTOCOL_MAGIC) {
        return RB_DECODE_ERR_MAGIC;
    }
    if (buf[2] != RB_PROTOCOL_VERSION) {
        return RB_DECODE_ERR_VERSION;
    }
    const rb_msg_type_t type = (rb_msg_type_t)buf[3];
    if (expected_len == 0) {
        return RB_DECODE_ERR_TYPE;
    }
    if (len != expected_len) {
        return RB_DECODE_ERR_LENGTH;
    }
    if (rb_crc16(buf, len - RB_CRC_LEN) != (uint16_t)(buf[len - 2] | (buf[len - 1] << 8))) {
        return RB_DECODE_ERR_CRC;
    }
    const rb_node_role_t role = (rb_node_role_t)buf[4];
    if (!role_ok(role, type)) {
        return RB_DECODE_ERR_ROLE;
    }

    memset(out, 0, sizeof(*out));
    *r = (reader_t){.p = buf, .n = 5};
    out->protocol_version = buf[2];
    out->type = type;
    out->role = role;
    out->node_id = get_u32(r);
    out->sequence = get_u32(r);
    out->uptime_ms = get_u32(r);
    return RB_DECODE_OK;
}

rb_decode_result_t rb_protocol_decode(const uint8_t *buf, size_t len, rb_packet_t *out)
{
    reader_t r;
    /* Too short to have a type byte: decode_header reports the length. */
    const size_t expected = buf != NULL && len > 3 ? packet_len((rb_msg_type_t)buf[3]) : 1;
    const rb_decode_result_t res = decode_header(buf, len, expected, out, &r);
    if (res != RB_DECODE_OK) {
        return res;
    }

    switch (out->type) {
    case RB_MSG_PRESENCE_DATA: {
        presence_reading_t *p = &out->body.presence;
        const uint8_t flags = get_u8(&r);
        p->valid = flags & FLAG_PRESENCE_VALID;
        p->presence_detected = flags & FLAG_PRESENCE_DETECTED;
        p->moving_target = flags & FLAG_PRESENCE_MOVING;
        p->stationary_target = flags & FLAG_PRESENCE_STATIONARY;
        p->distance_m = from_cm(get_u16(&r));
        p->timestamp_ms = get_u32(&r);
        break;
    }
    case RB_MSG_THERMAL_DATA: {
        thermal_reading_t *t = &out->body.thermal;
        t->valid = get_u8(&r) & FLAG_THERMAL_VALID;
        t->max_temp_c = from_centi((int16_t)get_u16(&r));
        t->min_temp_c = from_centi((int16_t)get_u16(&r));
        t->mean_temp_c = from_centi((int16_t)get_u16(&r));
        t->ambient_c = from_centi((int16_t)get_u16(&r));
        t->hot_region_temp_c = from_centi((int16_t)get_u16(&r));
        t->temp_rate_c_per_min = from_centi((int16_t)get_u16(&r));
        t->pixels_above_threshold = get_u16(&r);
        t->timestamp_ms = get_u32(&r);
        break;
    }
    case RB_MSG_HEARTBEAT:
        out->body.heartbeat.fault_flags = get_u16(&r);
        out->body.heartbeat.tx_ok = get_u32(&r);
        out->body.heartbeat.tx_fail = get_u32(&r);
        break;
    case RB_MSG_SENSOR_FAULT:
        out->body.fault.fault_flags = get_u16(&r);
        out->body.fault.changed_flags = get_u16(&r);
        out->body.fault.detail = (int32_t)get_u32(&r);
        break;
    case RB_MSG_C4002_CONFIG: {
        rb_c4002_config_msg_t *c = &out->body.c4002_config;
        c->target_node_id = get_u32(&r);
        c->request_id = get_u16(&r);
        c->action = get_u8(&r);
        c->field_mask = get_u16(&r);
        c->calib_delay_s = get_u16(&r);
        c->calib_duration_s = get_u16(&r);
        get_params(&r, &c->params);
        break;
    }
    case RB_MSG_C4002_CONFIG_ACK: {
        rb_c4002_ack_t *a = &out->body.c4002_ack;
        a->request_id = get_u16(&r);
        a->action = get_u8(&r);
        a->result = get_u8(&r);
        a->calib_remaining_s = get_u16(&r);
        a->saved = get_u8(&r);
        get_params(&r, &a->params);
        break;
    }
    case RB_MSG_C4002_LIVE: {
        rb_c4002_live_t *l = &out->body.c4002_live;
        l->target_state = get_u8(&r);
        l->resolution = get_u8(&r);
        l->presence_gate_mask = get_u32(&r);
        l->presence_countdown_s = get_u16(&r);
        l->presence_distance_cm = get_u16(&r);
        l->presence_energy = get_u8(&r);
        l->motion_distance_cm = get_u16(&r);
        l->motion_speed_cm_s = (int16_t)get_u16(&r);
        l->motion_energy = get_u8(&r);
        l->motion_direction = get_u8(&r);
        l->light_dlux = get_u16(&r);
        l->calib_remaining_s = get_u16(&r);
        l->age_ms = get_u16(&r);
        l->results = get_u32(&r);
        break;
    }
    case RB_MSG_THERMAL_CONFIG: {
        rb_thermal_config_msg_t *c = &out->body.thermal_config;
        c->target_node_id = get_u32(&r);
        c->request_id = get_u16(&r);
        c->action = get_u8(&r);
        c->hot_threshold_centi = (int16_t)get_u16(&r);
        break;
    }
    default:
        break;
    }
    return RB_DECODE_OK;
}

size_t rb_protocol_encode_frame_piece(const rb_packet_t *hdr, const rb_thermal_frame_piece_t *piece, uint8_t *buf,
                                      size_t buf_len)
{
    if (hdr == NULL || piece == NULL || buf == NULL || buf_len < RB_PKT_THERMAL_FRAME_LEN ||
        hdr->type != RB_MSG_THERMAL_FRAME || !role_ok(hdr->role, hdr->type) || piece->pieces != RB_FRAME_PIECES ||
        piece->piece >= RB_FRAME_PIECES || piece->step_centi == 0) {
        return 0;
    }
    writer_t w = {.p = buf, .n = 0};
    put_header(&w, hdr);
    put_u8(&w, piece->piece);
    put_u8(&w, piece->pieces);
    put_u16(&w, (uint16_t)piece->base_centi);
    put_u16(&w, piece->step_centi);
    put_u32(&w, piece->timestamp_ms);
    put_u16(&w, (uint16_t)piece->hot_threshold_centi);
    put_u8(&w, piece->hot_region_radius);
    memcpy(&w.p[w.n], piece->pixels, RB_FRAME_PIECE_PIXELS);
    w.n += RB_FRAME_PIECE_PIXELS;
    if (w.n + RB_CRC_LEN != RB_PKT_THERMAL_FRAME_LEN) {
        return 0;
    }
    put_u16(&w, rb_crc16(buf, w.n));
    return w.n;
}

bool rb_protocol_is_frame_piece(const uint8_t *buf, size_t len)
{
    return buf != NULL && len > 3 && buf[3] == RB_MSG_THERMAL_FRAME;
}

rb_decode_result_t rb_protocol_decode_frame_piece(const uint8_t *buf, size_t len, rb_packet_t *hdr,
                                                  rb_thermal_frame_piece_t *piece)
{
    reader_t r;
    const size_t expected = rb_protocol_is_frame_piece(buf, len) ? RB_PKT_THERMAL_FRAME_LEN : 0;
    const rb_decode_result_t res = decode_header(buf, len, expected, hdr, &r);
    if (res != RB_DECODE_OK) {
        return res;
    }
    piece->piece = get_u8(&r);
    piece->pieces = get_u8(&r);
    piece->base_centi = (int16_t)get_u16(&r);
    piece->step_centi = get_u16(&r);
    piece->timestamp_ms = get_u32(&r);
    piece->hot_threshold_centi = (int16_t)get_u16(&r);
    piece->hot_region_radius = get_u8(&r);
    memcpy(piece->pixels, &r.p[r.n], RB_FRAME_PIECE_PIXELS);
    /* A layout this firmware doesn't know (another piece count) is treated as a bad length. */
    if (piece->pieces != RB_FRAME_PIECES || piece->piece >= RB_FRAME_PIECES || piece->step_centi == 0) {
        return RB_DECODE_ERR_LENGTH;
    }
    return RB_DECODE_OK;
}

const char *rb_decode_result_name(rb_decode_result_t result)
{
    switch (result) {
    case RB_DECODE_OK: return "ok";
    case RB_DECODE_ERR_LENGTH: return "bad length";
    case RB_DECODE_ERR_MAGIC: return "bad magic";
    case RB_DECODE_ERR_VERSION: return "unsupported version";
    case RB_DECODE_ERR_TYPE: return "unknown message type";
    case RB_DECODE_ERR_CRC: return "CRC mismatch";
    case RB_DECODE_ERR_ROLE: return "bad node role";
    default: return "?";
    }
}

const char *rb_msg_type_name(rb_msg_type_t type)
{
    switch (type) {
    case RB_MSG_PRESENCE_DATA: return "PRESENCE_DATA";
    case RB_MSG_THERMAL_DATA: return "THERMAL_DATA";
    case RB_MSG_HEARTBEAT: return "HEARTBEAT";
    case RB_MSG_SENSOR_FAULT: return "SENSOR_FAULT";
    case RB_MSG_C4002_CONFIG: return "C4002_CONFIG";
    case RB_MSG_C4002_CONFIG_ACK: return "C4002_CONFIG_ACK";
    case RB_MSG_C4002_LIVE: return "C4002_LIVE";
    case RB_MSG_THERMAL_FRAME: return "THERMAL_FRAME";
    case RB_MSG_THERMAL_CONFIG: return "THERMAL_CONFIG";
    default: return "?";
    }
}

const char *rb_node_role_name(rb_node_role_t role)
{
    switch (role) {
    case RB_NODE_ROLE_PRESENCE: return "presence";
    case RB_NODE_ROLE_THERMAL: return "thermal";
    case RB_NODE_ROLE_CONTROLLER: return "controller";
    default: return "?";
    }
}

/* ---- C4002 parameters ---- */

#define C4002_MAX_RANGE_CM 1100u
#define C4002_MAX_THRESHOLD 99u

static const char *check_thresholds(const uint8_t *t)
{
    for (unsigned i = 0; i < RB_C4002_MAX_GATES; i++) {
        if (t[i] > C4002_MAX_THRESHOLD) {
            return "gate threshold > 99";
        }
    }
    return NULL;
}

const char *rb_c4002_params_check(const rb_c4002_params_t *p)
{
    if (p->report_period_ds == 0 || p->report_period_ds > RB_C4002_REPORT_PERIOD_MAX_DS) {
        return "report_period_ds must be 1..5";
    }
    if (p->range_max_cm > C4002_MAX_RANGE_CM) {
        return "range_max_cm > 1100";
    }
    if (p->range_min_cm > p->range_max_cm) {
        return "range_min_cm > range_max_cm";
    }
    if (p->resolution != RB_C4002_RES_80CM && p->resolution != RB_C4002_RES_20CM) {
        return "resolution must be 80 or 20 cm";
    }
    if (p->motion_sensitivity > RB_C4002_SENS_CUSTOM || p->presence_sensitivity > RB_C4002_SENS_CUSTOM) {
        return "sensitivity must be low, mid, high or custom";
    }
    if (p->motion_sensitivity == RB_C4002_SENS_CUSTOM && !(p->thresholds_known & RB_C4002_THRESH_MOTION)) {
        return "custom motion sensitivity needs motion thresholds";
    }
    if (p->presence_sensitivity == RB_C4002_SENS_CUSTOM && !(p->thresholds_known & RB_C4002_THRESH_PRESENCE)) {
        return "custom presence sensitivity needs presence thresholds";
    }
    if (p->lock_time_ds < 2 || p->lock_time_ds > 100) {
        return "lock_time_ds must be 2..100";
    }
    if ((p->motion_gate_mask | p->presence_gate_mask) & ~RB_C4002_ALL_GATES) {
        return "gate mask has bits above gate 24";
    }
    const char *why = check_thresholds(p->motion_thresholds);
    return why != NULL ? why : check_thresholds(p->presence_thresholds);
}

bool rb_data_packet_changed(const rb_packet_t *prev, const rb_packet_t *cur)
{
    if (cur->type != RB_MSG_PRESENCE_DATA) {
        return false;
    }
    if (prev == NULL || prev->type != RB_MSG_PRESENCE_DATA) {
        return true;
    }
    return prev->body.presence.valid != cur->body.presence.valid ||
           prev->body.presence.presence_detected != cur->body.presence.presence_detected;
}

void rb_c4002_params_merge(rb_c4002_params_t *dst, const rb_c4002_params_t *src, uint16_t m)
{
    if (m & RB_C4002_F_REPORT_PERIOD) dst->report_period_ds = src->report_period_ds;
    if (m & RB_C4002_F_RANGE_MIN) dst->range_min_cm = src->range_min_cm;
    if (m & RB_C4002_F_RANGE_MAX) dst->range_max_cm = src->range_max_cm;
    if (m & RB_C4002_F_RESOLUTION) dst->resolution = src->resolution;
    if (m & RB_C4002_F_MOTION_SENS) dst->motion_sensitivity = src->motion_sensitivity;
    if (m & RB_C4002_F_PRESENCE_SENS) dst->presence_sensitivity = src->presence_sensitivity;
    if (m & RB_C4002_F_DISAPPEAR_DELAY) dst->disappear_delay_s = src->disappear_delay_s;
    if (m & RB_C4002_F_LOCK_TIME) dst->lock_time_ds = src->lock_time_ds;
    if (m & RB_C4002_F_MOTION_GATES) dst->motion_gate_mask = src->motion_gate_mask;
    if (m & RB_C4002_F_PRESENCE_GATES) dst->presence_gate_mask = src->presence_gate_mask;
    if (m & RB_C4002_F_MOTION_THRESH) {
        memcpy(dst->motion_thresholds, src->motion_thresholds, RB_C4002_MAX_GATES);
        dst->thresholds_known |= RB_C4002_THRESH_MOTION;
        dst->motion_sensitivity = RB_C4002_SENS_CUSTOM;
    }
    if (m & RB_C4002_F_PRESENCE_THRESH) {
        memcpy(dst->presence_thresholds, src->presence_thresholds, RB_C4002_MAX_GATES);
        dst->thresholds_known |= RB_C4002_THRESH_PRESENCE;
        dst->presence_sensitivity = RB_C4002_SENS_CUSTOM;
    }
}

const char *rb_c4002_action_name(uint8_t action)
{
    switch (action) {
    case RB_C4002_ACTION_APPLY: return "apply";
    case RB_C4002_ACTION_CALIBRATE: return "calibrate";
    case RB_C4002_ACTION_READ: return "read";
    case RB_C4002_ACTION_RESET: return "reset";
    default: return "?";
    }
}

const char *rb_c4002_result_name(uint8_t result)
{
    switch (result) {
    case RB_C4002_RESULT_OK: return "ok";
    case RB_C4002_RESULT_INVALID: return "invalid";
    case RB_C4002_RESULT_SENSOR_ERROR: return "sensor_error";
    default: return "?";
    }
}
