Antonio-1110/RB4107_AY2627/main_controller/main/buzzer.h

#pragma once

#include <stdbool.h>
#include <stdint.h>
#include "esp_err.h"

esp_err_t buzzer_init(void);
void buzzer_on(void);
void buzzer_off(void);
void buzzer_beep(uint32_t duration_ms);
bool buzzer_is_on(void);
