Antonio-1110/RB4107_AY2627/(commit log)

2026-09-25 Section 0: establish repository structure
    Create firmware/ (one ESP-IDF project per TODO section plus shared
    components/), backend/, tools/ and docs/, and move the earlier prototypes
    into legacy/ for reference.
    Claude-Session: https://claude.ai/code/session_01GaPCK9ChNA6bU8yQ1EtH8g
2026-09-25 Section 1: ESP32-C6 sensor node base project
    Add the shared rb_config component (central Kconfig menu) and the
    01_c6_sensor_node_base project: boot info, MAC address, reset reason,
    periodic health log and a non-blocking status LED.
    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
    [main.c]
2026-09-25 Section 2: C4002 presence sensor integration
    Add the c4002 component (UART frame codec ported from DFRobot's library plus
    an ESP-IDF driver with a parser task, command/response handling and
    staleness-based validity), rb_types (presence/thermal reading structs),
    rb_node_sensors (menuconfig -> driver config) and the 02_c4002_integration
    project with false-detection investigation notes.
    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
2026-09-25 Section 3: MLX90640 integration and thermal feature extraction
    Vendor the official Melexis MLX90640 driver (Apache-2.0) behind an ESP-IDF
    I2C shim, add the pure-C thermal_features component (max/min/mean,
    hot-region temperature, pixels above threshold, rate of change, validity),
    menuconfig thresholds, the 03_mlx90640_integration project and an ASCII
    frame viewer for diagnostic dumps.
    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
2026-09-25 Section 4: shared, versioned ESP-NOW protocol
    Add the rb_protocol component (explicit little-endian serialisation,
    header with magic/version/type/node ID/sequence/uptime, SENSOR_DATA,
    HEARTBEAT and SENSOR_FAULT bodies, CRC-16, compile-time size checks),
    docs/protocol.md and the 04_espnow_protocol on-target self-test.
    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
2026-09-25 Section 5: ESP-NOW sender on the ESP32-C6 sensor node
    Add rb_wifi (shared Wi-Fi bring-up), rb_espnow (sender with sequence
    numbering and ACK-based delivery stats) and the 05_espnow_c6_sender
    project: thermal acquisition task plus a link task sending SENSOR_DATA,
    HEARTBEAT and on-change SENSOR_FAULT packets with rate-limited logging.
    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
2026-09-25 Section 6: ESP32-S3 central controller base project
    Add Waveshare board settings to menuconfig (pins from the legacy
    controller), the rb_board_s3 component (shared I2C bus + scan) and the
    06_s3_controller_base bring-up project, with the component mapping for
    the suggested folder structure documented in its README.
    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
2026-09-25 Section 7: ESP-NOW receiver on the ESP32-S3
    Add the non-blocking receive path to rb_espnow (decode + validation in the
    callback, per-reason reject counters, queue overflow counting), the pure-C
    sensor_node component (node ID check, sequence tracking with gap,
    duplicate, out-of-order and node-restart detection) and the
    07_espnow_s3_receiver project.
    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
2026-09-25 Section 8: sensor node health monitoring
    Extend sensor_node with ONLINE/STALE/OFFLINE link tracking, per-sensor
    validity with fault/recovery events, and tri-state safety inputs where
    missing data is UNKNOWN rather than safe. Add configurable stale/offline
    timeouts and the 08_sensor_health project.
    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
    [app_main.c, sensor_node.c, sensor_node.h]
2026-09-25 Section 9: hardware-independent safety state machine
    Add the pure-C safety component (BOOT/SELF_TEST/IDLE/MONITORING/UNATTENDED/
    WARNING/SHUTDOWN/FAULT with explicit entry/exit logic, per-state outputs,
    transition callback, monotonic non-blocking timers, and UNKNOWN inputs
    leading to FAULT without delaying a due shutdown), the design document and
    the 09_safety_state_machine simulated-scenario project.
    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
2026-09-25 Section 10: initial safety behaviour with configurable timings
    Add the Safety logic menuconfig (cooking thresholds, debounces, 60 s
    warning / 90 s shutdown, shutdown timing mode, warning-exit and cooling
    policies, fault shutdown), the rb_safety_config helper and the
    10_safety_behaviour project, which checks every required transition
    against the configured values, including the temperature-trend hook.
    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
2026-09-25 Section 11: non-blocking safety timing
    Add the rb_time component (esp_timer monotonic clock, wrap-safe elapsed
    check) and the 11_non_blocking_timing project: a safety task that steps
    the state machine on every queue wake-up or 100 ms tick while simulated
    sensor updates keep being processed during the warning/shutdown timers.
    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
2026-09-25 Section 11: reset the timing demo when the cook returns
    Verified in QEMU: WARNING at 5 s and SHUTDOWN at 10 s unattended while
    sensor updates keep being processed at 5 Hz.
    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
    [app_main.c]
2026-09-25 Section 12: FreeRTOS controller architecture
    Add the rb_controller component: ESP-NOW rx queue, high-priority safety
    task (node tracking/health, state machine, output hook), non-blocking
    event queue, mutex-protected snapshot, reset/config request flags.
    The 12_freertos_architecture project shows the safety loop carrying on
    through deliberate telemetry-task stalls.
    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
    [app_main.c]
2026-09-25 Section 13: buzzer driver with non-blocking patterns
    Add the buzzer component (active GPIO or passive LEDC tone, glitch-free
    init, esp_timer-driven WARNING/SHUTDOWN/FAULT/CHIRP patterns), buzzer
    menuconfig options and the 13_buzzer demo project.
    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
    [app_main.c, buzzer.c, buzzer.h]
2026-09-25 Section 14: relay / shutdown output driver
    Add the tca9554 expander driver (output-before-direction init, read-back,
    restore), the shutdown_output component (activate/release/verify with
    configurable channel, polarity and boot state), the rb_outputs glue that
    maps state-machine outputs onto buzzer and relay, and the
    14_relay_shutdown test project.
    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
    [app_main.c, tca9554.c, tca9554.h]
2026-09-25 Section 15: RTC and wall-clock time API
    Add the pcf85063 driver (UTC storage, oscillator-stop detection), the
    rb_wallclock component (restore from RTC, SNTP sync written back to the
    RTC, ISO 8601 timestamps derived from monotonic event times) and the
    15_rtc_time project with a persistence test procedure. Safety timing stays
    on rb_time's monotonic clock.
    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
    [app_main.c, pcf85063.c, pcf85063.h]
2026-09-25 Section 16: central fault manager
    Add the fault_manager component (fault table with SAFETY vs TELEMETRY
    classification, raise/clear with timestamps and counters, change
    callback), the rb_app fault glue (node health, ESP-NOW counters, queue
    overflows, relay, self-test) with a per-tick controller hook, and the
    16_fault_manager project showing that telemetry faults never change the
    safety state.
    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
2026-09-25 Section 17: S3 network connectivity (W5500 Ethernet / Wi-Fi)
    Add the rb_net component (W5500 SPI Ethernet via espressif/w5500 with an
    eFuse MAC, or Wi-Fi STA with exponential back-off; state tracking and
    callbacks), the broker host setting, offline-build documentation and the
    17_s3_network project that pings the MacBook once connected.
    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
    [app_main.c, rb_net.c, rb_net.h]
2026-09-25 Section 19: MQTT client on the ESP32-S3
    Add the rb_mqtt component (espressif/mqtt wrapper with DISCONNECTED/
    CONNECTING/CONNECTED tracking, retained online status plus Last Will,
    automatic reconnect, bounded outbox, non-blocking enqueue), MQTT
    menuconfig options, a QEMU OpenETH network option for hardware-free
    testing and the 19_mqtt_client project. Connect, disconnect detection
    and automatic reconnect verified in QEMU against Mosquitto.
    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
2026-09-25 Section 20: MQTT topic structure
    Add the rb_topics component (single table of topics with QoS/retain
    policy, configurable prefix, per-node topics), docs/mqtt_topics.md and
    the 20_mqtt_topics project that prints the tree and publishes a test
    message per topic (verified in QEMU against Mosquitto).
    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
2026-09-25 Section 22: MQTT publishing strategy
    Add the rb_telemetry task (1 Hz QoS 0 telemetry, heartbeat and sensor
    topics; immediate QoS 1 state, warning, shutdown, fault and node-status
    messages), rb_connectivity (network -> SNTP -> MQTT with telemetry
    faults), the rb_sim simulated sensor node, a simulated-outputs option and
    the 22_mqtt_publishing project.
    Fixes found while testing in QEMU: publish directly instead of enqueueing
    (QoS 0 items were crowding QoS 1 events out of the outbox) and create the
    controller queues before boot faults are raised (rb_controller_init).
    A 125 s QEMU run produced 510 schema-valid messages with no sequence gaps.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
    [app_main.c]
2026-09-25 Section 25: logging conventions
    Add the rb_log component (per-tag DEBUG/WARN levels from menuconfig,
    RB_LOG_EVERY_MS rate limiting), use it for event-queue drops and thermal
    read failures, call rb_log_init() in the complete firmwares, and document
    tags, format, rules and verbosity controls in docs/logging.md.
    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
    [app_main.c, main.c, node_thermal.c]
2026-09-25 Section 26: centralised configuration reference
    Add an optional temperature-rate heat-detection threshold
    (RB_SAFETY_HEAT_ON_RATE_DC_PER_MIN, off by default), the kconfig_doc.py
    generator, and the generated docs/configuration.md listing every option
    with defaults, ranges, unconfirmed flags and a map of the TODO section 26
    items.
    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
2026-09-25 Section 27: diagnostic mode
    Add the rb_diag esp_console shell (status/presence/thermal/espnow/node/
    safety/faults/mqtt, simulated inputs through rb_sim, accelerated test
    timers via the same state machine, operator reset, runtime log levels),
    the rb_controller_app component wiring the complete controller, and the
    27_diagnostic_mode project. A scripted console session was driven in
    QEMU through heating, absence, warning, shutdown, reset and an MLX fault.
    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
    [app_main.c, rb_diag.c, rb_diag.h]
2026-09-25 Section 28: state machine tests on host and target
    Add the 28_state_machine_tests Unity project (47 tests) covering every
    required scenario plus sequence tracking, node health, fault classes,
    protocol, C4002 codec, thermal features and JSON. It runs on the ESP-IDF
    linux target and on the ESP32-S3; both pass. Add tools/run_host_tests.sh.
    The tests exposed a bug: FAULT recovered to IDLE immediately after a
    failed or timed-out self-test because only the sensors were checked. The
    state machine now requires the self-test to read PASS before FAULT can
    clear. rb_protocol links libm on the linux target.
    Claude-Session: https://claude.ai/code/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
2026-09-25 Section 30: critical failure test
    Add the 30_critical_failure_test project (production controller plus a
    low-priority continuity monitor that logs safety-loop liveness, state,
    node link and outputs during an MQTT outage and prints a PASS/FAIL
    verdict on reconnect) and critical_failure_test.py, which stops and
    restarts Mosquitto and checks resume, no reboot, safety-loop progress and
    the reported telemetry fault. Rehearsed in QEMU: WARNING and SHUTDOWN
    happened with the broker down; both sides reported PASS.
    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
    [app_main.c]
2026-09-25 Consolidate firmware to 10 ESP-IDF projects
    Keep the two complete firmwares (05 C6 sensor node, 29 S3 controller),
    the unit tests (28) and the hardware bring-up projects (02, 03, 06, 13,
    14, 15, 17). Remove 01, 04, 07-12, 16, 19-22, 27 and 30, whose code
    already lived in shared components and whose coverage moves to:
    - 29: diagnostic console plus a new sdkconfig.qemu overlay (section 27),
    and the continuity monitor, now rb_diag's rb_continuity behind
    RB_DIAG_CONTINUITY_MONITOR (section 30)
    - 05: boot report, heap/uptime log and status LED from 01 (section 1)
    - 28: new test_kconfig.c checks the menuconfig safety timings (section 10)
    - docs/architecture.md: tasks and queues, node health,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
2026-09-25 28: all 49 tests now also pass on the ESP32-S3 in QEMU
    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
2026-09-26 Three sensor nodes: two C4002 presence nodes and one thermal node
    The sensing side is now three ESP32-C6 boards, one sensor each, instead of
    one C6 with both sensors.
    - Protocol v2: separate PRESENCE_DATA and THERMAL_DATA packets; every
    packet carries the sender's role, checked by encoder and decoder.
    - Node firmware split into 05a_c6_presence_node (flashed twice, node IDs
    1 and 2 via sdkconfig.node_b) and 05b_c6_thermal_node (node ID 3). Board
    checks and the ESP-NOW link task move to the shared rb_node_app component.
    - Controller tracks each node separately (sequence, link health, faults)
    and combines the two radars strictly: PRESENT if either sees a person,
    ABSENT only if both v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
2026-09-27 02: note why the Arduino C4002 example repeats the same reading
    DFRobot_C4002::getNoteInfo() returns an uninitialised noteType when no
    frame arrived, so the example re-prints the last cached result. Document
    it and how to check freshness with this driver (age=, frames=).
    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
2026-09-28 C6 pin defaults from the DFR1117 schematic
    C4002 on IO4/IO5 (header P3) instead of UART0's IO16/IO17, status LED on
    IO15 (confirmed). The IO4/IO5 direction and the MLX I2C pins stay flagged
    as unconfirmed. Document how to set options in a file instead of
    menuconfig.
    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
2026-09-28 Firmware layout: named system firmware, test projects under testing/
    firmware/presence_node, thermal_node and controller are the three system
    firmwares (one per board type). Every test-only project moves under
    firmware/testing/ with a plain name (c4002, mlx90640, s3_board, buzzer,
    relay, rtc, network, unit_tests). No more TODO-section numbers in folder
    names; READMEs, docs, Kconfig help, tools and CMake project names follow.
    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
    [app_main.c, main.c, node_thermal.c, node_thermal.h, rb_protocol.h]
2026-09-29 Connect AES multi-stall dashboard to firmware MQTT ingestion
2026-09-30 Clean up dashboard: move frontend out of backend, drop .jw names
    - Move the dashboard to frontend/ (index.html, css/, js/) as plain static
    files; Django serves them at / so page and API stay same-origin.
    - Split dashboard.js into ES modules (config, api, chart, dom, format) and
    format CSS/JS/HTML with Prettier.
    - Rename .jw files; move smoke/browser checks to tools/dashboard/.
    - Limit state classification to the firmware's schema-v2 enums and drop
    fields the firmware never sends (cooking state, timer settings).
    - Split locations.json (bench controller) from locations.demo.json, with
    fictional stall names instead of real outlets.
    - Remove personal server, Fish, v2.2 and AES references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
2026-09-30 Add boot_id, explicit reset flag and node restart fault
    Firmware:
    - Every MQTT message (and the Last Will) carries a random per-boot
    boot_id, so the backend can order messages across reboots without a
    wall clock.
    - Telemetry safety block publishes reset_required (from
    safety_reset_required()) plus warning_after_ms, shutdown_after_ms and
    shutdown_counts_from.
    - sensor_node flags a node that reboots RB_CTRL_NODE_RESTART_LIMIT times
    within RB_CTRL_NODE_RESTART_WINDOW_S; raised as the node_restarting
    telemetry fault.
    Backend/dashboard:
    - Order messages by (boot_id, sequence): older ones are stored as
    historical/duplicate and never change current state; a new boot_id is
    logged as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
2026-09-30 Clean up docs: issues replace TODO.md, setup guide, django/ at top level
    - Move unfinished TODO.md items to GitHub issues (#19-#26) and delete TODO.md,
    docs/open_questions.md and docs/engineering_rules.md
    - README now only introduces the project; build/flash/run steps move to the
    new docs/setup.md, with docs/README.md as the index
    - Move the agent handover to docs/agent-context/handover.md and bring it up
    to date
    - Move backend/django to django/ and update settings, scripts and docs
    - Remove legacy/ (references in Kconfig help text reworded)
    - Trim TODO-section references and duplicated setup text from the READMEs
    Cl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
    [MLX90640_Testing.ino, RB4107_MQTT_POC.ino, buzzer.c, buzzer.h]
2026-09-30 Docs: controller is the ESP32-S3-POE-ETH-8DI-8DO (no onboard relays)
    The outputs are opto-isolated transistor sinks, so the shutdown drives an
    external relay or contactor. Docs only; code and Kconfig menu names still say
    8DI-8RO.
    Claude-Session: https://claude.ai/code/session_01RihpqQXZQTp8brsF7GL4JN
2026-09-30 Add servo gas valve node (wired and wireless) and the controller side
    - firmware/valve_node: any ESP32 drives a hobby servo on a gas ball valve.
    Wired: controller output pulls an input low while safe. Wireless:
    ESP-NOW KEEP_OPEN heartbeat, closes on CLOSE or 3 s of silence and
    replies with VALVE_STATUS. Both fail closed.
    - components/servo, valve_logic (host-testable), rb_valve_link.
    - rb_protocol: VALVE_COMMAND / VALVE_STATUS, valve and controller roles,
    stricter role checks. Existing messages unchanged.
    - shutdown_output: optional wired valve line (RB_SHUTDOWN_VALVE_CHANNEL,
    default 0 = off), ON while safe.
    - controller: wireless valve link behind RB_CTRL_VALVE_WIRELESS (default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
    [app_main.c, main.c, rb_protocol.c, rb_protocol.h]
2026-10-02 Add remote C4002 radar tuning from the dashboard
    Dashboard -> Django -> MQTT c4002_set -> S3 -> ESP-NOW C4002_CONFIG ->
    presence node -> UART C4002, with the node's ACK coming back as a
    retained c4002_config message. Covers range, resolution, sensitivity,
    hold/lock time, report period, per-gate enable and thresholds,
    calibration, read-back and reset. Settings are saved in NVS on the node.
    Claude-Session: https://claude.ai/code/session_015ZtXcQgzQgvFpqeY9fWbF1
    [c4002.c, c4002.h, main.c]
2026-10-02 Add a live C4002 radar view next to the tuning panel
    Presence nodes forward each new raw C4002 result (C4002_LIVE, type 9,
    46 bytes, at most every RB_C4002_LIVE_PERIOD_MS = 250 ms). The S3
    publishes it on sensors/<node>/c4002_live (QoS 0), Django stores it and
    serves the last minute at .../nodes/<node>/c4002/live/, and the dashboard
    draws a distance-over-time chart: stationary gates firing, the moving
    target, turned-off gates, range limits, when settings were applied, and
    how often each gate fired. The safety logic does not use it.
    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
2026-10-02 Heat map: send the whole MLX90640 picture to the dashboard
    The thermal node encodes each 32x24 picture at 1 byte per pixel (range
    fitted to the picture, at least 0.1 degC steps) and sends it every
    RB_THERMAL_HEATMAP_PERIOD_MS as 4 THERMAL_FRAME pieces (type 10, 223 bytes,
    within the 250-byte ESP-NOW v1 limit), one piece per link tick.
    The S3 diverts the pieces in the ESP-NOW receive callback (they never enter
    the safety queue), reassembles complete pictures from the configured thermal
    node, and the telemetry task publishes them on sensors/<node>/thermal_frame
    (QoS 0, not retained). Display only: the safety logic is unchanged.
    Django validates the new message, keeps only the latest picture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
2026-10-02 Heat map: show the node's threshold and hot region, add a pixel-size calculator
    THERMAL_FRAME now also carries the node's hot-pixel threshold and hot-region
    radius (packet 224 bytes). The dashboard outlines the pixels above the
    threshold, boxes the hot region, shows the node's own hot-region temperature
    and hot-pixel count next to the picture, and works out the pixel size at a
    chosen distance for the 55° and 110° lenses.
    Claude-Session: https://claude.ai/code/session_01JqZSBCm6drsLDg68jyNSiK
2026-10-03 Reset a latched shutdown from the dashboard
    Adds a "Reset shutdown" button to the dashboard's System status card. It
    calls POST /api/devices/<id>/reset/, Django publishes a controller_command
    on <prefix>/controller/command (QoS 1, not retained), and the S3 parses it
    (new rb_ctrl_cmd component) and calls rb_controller_request_reset(), the
    same as the console's reset command. Reuses the MQTT command path from the
    C4002 tuning branch. On by default (RB_CTRL_REMOTE_RESET).
    Claude-Session: https://claude.ai/code/session_01PZpBrnKDyYABaw5u2oTeiS
2026-10-06 Make bench-confirmed sensor node pins the Kconfig defaults
    C4002 RX=IO4 / TX=IO5 and MLX90640 SDA=IO6 / SCL=IO7, as used by the
    working testing/c4002 and testing/mlx90640 builds on the bench.
    Drops the UNCONFIRMED notes, updates the READMEs and regenerates
    docs/configuration.md.
    Claude-Session: https://claude.ai/code/session_016vLZ4fGqYfsi9GjFZnGcg2
2026-10-06 Port bench fixes: passive buzzer default, 8 KB MLX90640 stacks
    From the local bench-results branch: the Waveshare buzzer is passive
    (a DC level only clicks), and MLX90640_ExtractParameters() keeps a
    3 KB table on the stack, so the thermal task and the mlx90640 test's
    main task get 8 KB.
    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
    [node_thermal.c]
2026-10-06 Fix small multi-day run issues from the review
    - Live radar API: match the exact topic and order by received_at so
    SQLite uses a new (device, topic, received_at) index instead of
    scanning every row of the device (0.7 s -> <1 ms at ~1.1 M rows).
    - SQLite in WAL mode so dashboard reads don't block subscriber writes.
    - Thermal node: create the I2C bus once and unregister the MLX90640
    device after a failed init, so the boot retry loop can succeed and
    doesn't add a device on every attempt.
    - Presence node: retry applying C4002 settings up to 3 times at boot.
    - Controller telemetry: rb_controller_get_snapshot() reports whether it
    got the snapshot; telemetry skips publishing an all-zero s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
    [mlx90640.c, rb_node_sensors.c]
2026-10-06 Default the shutdown output to the 8DI-8DO's polarity, fail-safe
    On the Waveshare 8DI-8DO a low TCA9554 pin switches the digital output
    on, confirmed on the bench: with active level 1 every unused output was
    lit and the shutdown output was inverted. The output now stays on
    (appliance circuit closed) while safe and turns off on shutdown or when
    the controller loses power.
    - RB_RELAY_ACTIVE_LEVEL defaults to 0
    - RB_SHUTDOWN_POLARITY defaults to de-energise to shut down
2026-10-06 Track ESP-IDF dependencies.lock files, ignore .clangd
    dependencies.lock pins the managed component versions so every build uses
    the same ones. .clangd is per-editor config, like .vscode/.
2026-10-06 C4002 test: use the current state as the log tag
    Every line is tagged MOVING, STATIONARY, NO TARGET, INVALID, NO REPORT
    (stale) or NOTHING RECEIVED instead of a fixed PRESENCE tag.
    [main.c]
2026-10-07 Track valve_node dependencies.lock
2026-10-07 ESP-NOW nodes follow the controller's Wi-Fi channel (#40)
    On Wi-Fi the access point sets the controller's channel, and the nodes
    were fixed to RB_ESPNOW_CHANNEL, so an AP on another channel (or one that
    changes channel) took every node OFFLINE and led to SHUTDOWN.
    - rb_espnow: rb_espnow_follow_start(). After RB_ESPNOW_LOST_FAILURES
    unacknowledged packets in a row, a task probes the current channel and
    then 1-13, waiting for each probe's own send result, and stays on the
    first one the controller acknowledges. The channel is saved in NVS for
    the next boot. Off with RB_ESPNOW_FOLLOW_CHANNEL=n, and skipped when the
    controller MAC is broadcast (never acknowledged).
    - Sensor nodes probe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
    [main.c, rb_net.c, rb_node_link.c]
2026-10-07 Dev scripts: stop_dev.sh, run_demo.sh, LAN dashboard at 192.168.1.50; fix read-only docs
    - tools/stop_dev.sh stops what run_dev.sh / run_demo.sh started (via its
    PID file), then any leftover broker, subscriber, simulator or runserver
    of this project. Other projects' processes are left alone.
    - tools/run_demo.sh: dashboard with the simulated stalls of
    locations.demo.json (simulate_fleet --direct, no broker) in a separate
    django/demo.sqlite3. Implemented as RB4107_DEMO=1 in run_dev.sh.
    - run_dev.sh listens on 0.0.0.0:8000 by default, prints the LAN URL,
    refuses to start twice and stops cleanly when its terminal closes.
    - The MacBook's fixed IP 192.168.1.50 is the controller's RB_BROK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
2026-10-07 Demo: simulated stalls next to the real controller, one run_dev.sh --demo
    - run_dev.sh --demo replaces run_demo.sh: broker, subscriber and dashboard
    as usual, plus simulate_fleet over MQTT, so the real controller_01 shows
    next to the simulated stalls (demo data still in django/demo.sqlite3).
    - One MQTT tree per controller: the controller publishes under
    rb4107/controller_01 (sdkconfig.defaults) and Django subscribes to
    rb4107/+/# (.env.example). Fix: commands (reset, C4002 tuning) went to
    rb4107/+/..., a wildcard topic that can't be published to; they now go
    to the controller's own tree.
    - Simulator: one scenario per stall (demo_scenario in locations.demo.json).
    New: network_lo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
2026-10-07 Controller network: Ethernet first, Wi-Fi when Ethernet is down
    New default RB_NET_TYPE = RB_NET_ETHERNET_WIFI. Ethernet is used whenever
    it has an IP address. After RB_NET_FALLBACK_S (5 s) without one (cable
    out, no DHCP, W5500 not responding) the controller joins RB_WIFI_SSID, and
    leaves Wi-Fi as soon as Ethernet has an address again. With no SSID set it
    is Ethernet only. Ethernet-only and Wi-Fi-only stay available.
    - rb_net: Ethernet and Wi-Fi each keep their own state; rb_net_state(),
    rb_net_ip() and rb_net_interface_name() report Ethernet while it has an
    address, otherwise Wi-Fi. Fallback decisions run in the default event
    loop (the timer only posts an event).
    - Ethernet's netif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
2026-10-07 Default the controller MAC on the nodes and the broker to the MacBook's .local name
    These don't change for this project, so they move from each person's
    git-ignored sdkconfig into the committed sdkconfig.defaults.
    - presence_node, thermal_node, valve_node: RB_NODE_CONTROLLER_MAC is the
    controller S3's STA MAC (44:B1:76:A9:BB:6C). With broadcast, sends are
    never acknowledged, so a node could not follow the controller to a Wi-Fi
    channel (#40).
    - New RB_BROKER_FALLBACK_HOST. After every failed connection attempt the
    MQTT client switches between RB_BROKER_HOST and the fallback, so one of
    them can be the MacBook's mDNS name (works on any network) and the other
    its fixed lab IP.
    - con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
    [rb_diag.c]
2026-10-07 Hardware defaults everywhere: no configuration needed for the demo
    - C4002: 20 cm resolution, 5 m range by default (the tuned stall setup).
    - Django: the demo setup is the default (MQTT topic rb4107/+/#, allowed
    hosts include 192.168.1.50 and AntoniodeMacBook-Air.local), so
    django/.env is optional; run_dev.sh no longer asks for it.
    - setup.md: no menuconfig or .env steps; delete an old sdkconfig so new
    defaults apply. Configuration reference regenerated.
2026-10-07 Wi-Fi reconnect back-off: 1, 2, 4, 8, 16 s, then from 1 s again
    A slow router (the home one takes a while to accept the board) used to
    push the retry interval up to 30 s and keep it there, so the controller
    waited long after the router was ready. Now the wait doubles up to
    RB_WIFI_MAX_BACKOFF_MS, default 16000, and then starts over at 1 s.
2026-10-07 Django: SQLite transactions take the write lock up front (fix 'database is locked')
    The subscriber writes from two threads: message handling (c4002_live alone
    is 4 messages a second per radar) and the worker heartbeat every 2 s. Both
    run transactions that read first and then write. In WAL mode, when the
    other thread commits in between, the upgrade to a write fails immediately
    with 'database is locked', without waiting for the 20 s timeout, and the
    message is lost. transaction_mode IMMEDIATE (Django 5.1+) begins each
    transaction with the write lock, so the second writer waits instead.
    A stress test with both threads (real handle() and worker_status()) went
    from 1128 errors in 15 s to none.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
2026-10-07 Erase the recorded data when the stack stops
    run_dev.sh (Ctrl-C, closed terminal, stop_dev.sh) and stop_dev.sh (also
    after a crash or kill -9) delete django/db.sqlite3 and demo.sqlite3 with
    their WAL files, so no demo data is kept and every run starts empty.
    stop_dev.sh keeps the data if a process could not be stopped. The demo's
    made-up stalls are generated, so --demo brings them back within seconds.
2026-10-07 Dashboard: show whether cooking is active
    Each controller and stall gets a cooking status (classify_cooking in
    django/ingest/locations.py), shown as a badge on the stall tiles and
    roster, a banner on the stall page and a 'Cooking now' count.
    It follows the firmware's own decision, i.e. its safety state:
    MONITORING/UNATTENDED/WARNING = cooking, IDLE = not cooking, SHUTDOWN =
    supply cut. When the state can't say (FAULT, starting up), it guesses
    from the hot region with the firmware's default thresholds (50 / 40 degC,
    still being tuned, issue #21) and labels it 'likely'. Display only.
2026-10-08 Dashboard: count each stall in exactly one summary card
    An offline stall with no active alarm was counted under both
    "Unknown / stale" and "Connectivity issue". Active alarms keep their
    severity when offline; other offline/stale stalls count only as a
    connectivity issue, so the cards add up to the total. The status filter
    and the browser's last-known fallback use the same buckets.
    Claude-Session: https://claude.ai/code/session_01MK9YD4UQwNUC5hqvr2iK1e
2026-10-10 Presence nodes: pick node ID from the board's MAC
    Adds RB_NODE_ID_BY_MAC ("MAC=ID, MAC=ID") so both presence nodes run one
    build: each looks up its own Wi-Fi STA MAC at boot and falls back to
    RB_NODE_ID when it isn't listed. Controller, topics and dashboard unchanged.
    Claude-Session: https://claude.ai/code/session_01Rz1FrzLksLZiRRKLJeTmSR
2026-10-10 Presence return filter: a single radar reading no longer resets the unattended timer
    A person "returning" during UNATTENDED/WARNING now has to be seen for 3 s
    (RB_SAFETY_PRESENCE_RETURN_DEBOUNCE_MS, was 0) before the timers are
    cancelled, so a hand waved at the C4002 or someone walking past leaves
    the timeline running. Absent gaps shorter than 1 s
    (RB_SAFETY_PRESENCE_RETURN_GAP_MS) don't restart that count, and the
    person must still be detected when it completes.
    The three presence filter values can be changed live from the dashboard
    (System status card -> POST /api/devices/<id>/presence_filter/ ->
    controller_command "presence_filter" / "presence_filter_defaults"), until
    the controller rebo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
2026-10-13 Presence nodes: fill in both radar boards' MACs
    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
2026-10-13 Dashboard: tune and calibrate all radars at once
    Radar tuning gets an "All radars" target (the default with two or more
    presence nodes). Each command goes to every presence node through the
    existing per-node API, and the status shows each node's answer. No
    firmware or Django change.
    Claude-Session: https://claude.ai/code/session_01NCiXfUFpGmgfiS3qvsLonN
2026-10-13 Live radar view: look up c4002_live under the controller's own topic tree
    Since the default subscription became rb4107/+/#, live results are stored as
    rb4107/<controller_id>/sensors/<node>/c4002_live, but the live view queried
    rb4107/+/sensors/<node>/c4002_live and always came back empty. Fill in the
    controller ID the same way commands do.
    Claude-Session: https://claude.ai/code/session_01Ek1gpXFXd6FgR49ddrEKU2
2026-10-13 Dashboard: set the thermal node's hot-pixel threshold
    The Thermal camera card gets a threshold field with Apply and Menuconfig
    value. Django publishes a "thermal_threshold" controller command, the S3
    forwards it over ESP-NOW (new THERMAL_CONFIG, type 11) to the thermal node,
    which uses it from the next frame and saves it in NVS. The threshold in use
    already rides in every heat-map picture, so the card confirms the change
    from there. Display and telemetry only: the safety logic does not use it.
    Claude-Session: https://claude.ai/code/session_01PVCruWHrxFALu4oXzQ4WUz
2026-10-13 Dashboard sets buzzer and shutdown times; shorter demo defaults
    The System status card's presence filter becomes "Presence filter and
    timers": two more fields, Buzzer after and Shut down after, travel with the
    existing presence_filter command (warning_ms, shutdown_ms, 1-3600 s) and
    stay in force until a reboot or "Menuconfig values". The controller refuses
    and logs a set where shutdown would not come after the warning; the
    dashboard checks the same before sending.
    Defaults for the demo: absence filter 1 s (was 2 s), warning 20 s (was
    60 s), shutdown 40 s from the start of UNATTENDED (was 90 s).
    Claude-Session: https://cla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
2026-10-13 One cooking temperature: hottest pixel vs a dashboard-settable value
    The controller now counts the stove as cooking when the hottest pixel
    reaches the cooking temperature (RB_SAFETY_HEAT_ON_DC, 50 C), instead of
    the 3x3 hot-region average. The dashboard sets that temperature (saved in
    controller NVS); the controller forwards it to the thermal node as its
    hot-pixel threshold and reports on/off values in telemetry
    (safety.cooking), which the dashboard outline and cooking badge use.
    Replaces the separate display-only hot-pixel threshold control.
    Claude-Session: https://claude.ai/code/session_01BhXc9JFF7Y8CwHDsR3x8Pa
2026-10-13 Safety: noise-robust absence timer; lost sensors raise flags instead of FAULT
    A presence blip no longer restarts the absence debounce; only a confirmed
    return does. Presence UNKNOWN while cooking counts as absent; UNKNOWN with
    no heat starts no timer. A lost thermal camera only raises a flag and keeps
    the last cooking state. FAULT is now only for self-test and relay-output
    failures (fault_controller_fault_active).
2026-10-13 Telemetry: report sensor flags, cooking state and debounce progress
    safety.presence_unknown / thermal_lost / absent_ms / returning_ms and
    safety.cooking.active go through rb_telemetry, the MQTT schema and Django's
    normalization. The command schema allows only the fixed radar holds. Demo
    scenarios follow the new rules (a lost radar while cooking runs the timeline
    instead of FAULT).
2026-10-13 Controller: publish telemetry at once when presence, cooking or a sensor flag changes
2026-10-13 Dashboard: big Countdown card with the cooking, person and timer rules
    One large card on the stall page shows the phase (confirming absence,
    unattended, warning, shutdown), a clock that counts smoothly between reports,
    a bar with the warning and shutdown marks, per-node OK / SENSOR PROBLEM /
    OFFLINE chips and the presence-unknown / thermal-lost flags. The three rules
    show their live values and their adjustable settings (the cooking temperature
    and the presence filter / timers moved here from the thermal and System status
    cards). The radar hold and lock time fields are read-only.
2026-10-13 Docs and tests: lost-sensor rules, S3-only debouncing, Countdown card
    Updates the safety state machine, architecture, MQTT schema, dashboard,
    protocol, remote-reset and unit-test docs for the new behaviour. Also fixes
    test_sensor_node.c and test_kconfig.c, which still used the safety input
    field removed by the cooking-temperature change (the unit-test app could not
    compile), and lengthens the radar-disappears test so the stale radar is
    followed by the absence debounce.
2026-10-13 Dashboard: Monitor and Tuning modes, laptop layout, compact overview, dark theme
    Monitor (default) fits one laptop screen and shows only what a deployment
    needs; Tuning adds Rules / Radar / Thermal / Diagnostics tabs with the editable
    rules, radar tuning and thermal controls. The mode switch is cosmetic. The
    header, alerts and fleet strip are compacted, the overview has Tiles / Table
    views, and a Light / Dark / Auto theme is built on CSS variables (canvases read
    them too). The live radar stream is only polled in Tuning.
2026-10-13 Cooking judgment: temperature trend, cookware profiles, bounded holds
    The S3 fits the last two minutes of hottest-pixel temperatures and estimates
    where the temperature is heading (T + tau * rate, tau from a cookware profile:
    mixed / light / heavy / liquid). A pan that is only cooling holds the buzzer and
    shutdown back (at most 4 time constants / 1 h); a flat or settling-hot trend,
    boiling, a lowered flame or no trend data counts as heat going in. A held
    timeline always gets at least 30 s of buzzer before the shutdown. A due
    buzzer/shutdown also waits while the radar sees someone and the return is being
    confirmed (bounded). The profile is set by a controller command, saved in NVS,
    and report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
2026-10-13 Backend: cookware command and trend fields, retention job
    POST /api/devices/<id>/cookware/ sends the cookware profile; telemetry's
    cooking phase / rate / settle temperature, hold reason and cookware profile are
    validated, normalised and shown in the demo (new 'cooling' scenario). The
    subscriber prunes once an hour (ingest/retention.py, manage.py prune_history):
    high-rate topics after 24 h, telemetry thinned to one per minute after 24 h and
    deleted after 30 days, other messages after 90 days; safety events and the
    messages that carry them are kept.
2026-10-13 Dashboard and docs: cookware profile selector, cooling hold in the countdown, storage and retention
    Tuning > Rules gets the cookware profile; the Countdown shows 'held while the
    pan cools' / 'held, a return is being confirmed' and the Cooking tile shows the
    trend phase, rate and where the temperature is heading. Docs: cooking judgment,
    holds, cookware profiles and what a wrong profile costs, measured storage per
    message and the retention settings. tools/diagnostics/cooling_sweep.c reproduces
    the simulated profile sweep.
2026-10-13 Longer default timers (buzzer 3 min, shutdown 5 min); cooling judgment checks itself
    The defaults were 20 s and 40 s, shorter than the temperature trend needs
    (about 1-2 minutes), so the demo could only show that the timers run. Now 180 s
    and 300 s: the controller can tell a cooling pan from a lowered flame before the
    buzzer is due. 'Cooling' is only believed while the settling estimate is stable
    (it climbs when the profile is slower than the pan), so a mismatched profile
    delays a lowered-flame buzzer by about a minute at most instead of holding it;
    the default mixed profile is now 10 min. New tests run the menuconfig defaults
    through burner-off and burner-on-low. Demo scenarios, docs and th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
2026-10-13 Temperature-tiered timers: the hotter the pan, the shorter the time
    ELEVATED (120 degC and up: buzzer 60 s, shutdown 150 s) and CRITICAL (200 degC
    and up, or rising 20 degC/min above 150: buzzer 30 s, shutdown 120 s) shorten the
    base times (3 min / 5 min, a simmer); a tier never lengthens them. A tier takes
    over after its temperature has held for 4 s and gives way 10 degC lower after
    20 s; a lost camera keeps the tier. The shutdown is later than the time the
    cooling judgment needs, so a hot pan whose burner was switched off gets a buzzer
    but not a gas cut. If the limits get shorter while nobody is there, the buzzer
    still sounds 10 s before the shutdown. The trend now weights recent samples
    (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
2026-10-13 Dashboard and docs for the temperature tiers
    The Countdown card draws its clock, bar and marks from the buzzer and shutdown
    times in force, shows a tier chip and 'hot oil range, short limits'; Tuning >
    Rules lists the tiers. Docs: the tiers and why the hot tiers' shutdown comes
    after cooling can be recognised, the Kconfig rows, the schema example, the
    README and the demo-vs-deployment record.
2026-10-13 Temperature tiers: settable from the dashboard, saved on the controller
    A 'tiers' controller command (and POST /api/devices/<id>/tiers/) replaces the
    RB_SAFETY_TIER* values; the controller keeps them in NVS, refuses inconsistent
    sets (shutdown not after its warning, CRITICAL below ELEVATED) and reports the
    source in telemetry. Menuconfig: RB_CTRL_REMOTE_TIERS.
2026-10-13 Dashboard: edit the temperature tiers; docs for tiers and for rear radar detections
    Tuning > Rules gets the eight tier fields (apply, menuconfig values, status).
    docs/c4002_tuning.md explains what the radar settings can and cannot do about
    detections behind or beside the sensor (distance only, no angle), what could be
    verified about a metal enclosure (24 GHz does not pass thick metal, but metal also
    reflects) and what could not (the C4002's rear pattern), and how to measure it
    with the live view. The gap is recorded in docs/demo_vs_deployment.md.
2026-10-13 Attendance: pause the clock while someone is at the stove, cancel after 5 s; both radars must agree
    On an unattended timeline the clock stops while someone is at the stove, so a
    person passing delays the timers by its length but resets nothing; 5 s of
    presence cancels the timeline (the return debounce, was 3 s). Each timeline has
    a pause budget (30 s and at most 25% of the shutdown time in force) so a busy
    aisle cannot stall it. 'At the stove' now needs every working radar to see
    someone (a radar that is down is not asked); 'nearby' (either radar) is only
    reported. Both are settable from the dashboard through a new 'attendance'
    command, saved on the controller.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
2026-10-15 Fix the controller rebooting every ~10 s: continuity task stack overflow
    rb_snapshot_t grew to 1408 bytes with this week's features. The
    continuity monitor kept two of them on its 4 KB stack plus a long
    ESP_LOGW, overflowed, and rebooted the controller about 10 s after boot,
    just as MQTT started connecting, so it never reached the broker.
    - rb_continuity: keep only the previous loop count and state, and make
    the working snapshot static (there is one monitor task).
    - rb_diag: console REPL stack 8 KB; each command keeps a snapshot and a
    long printf on the default 4 KB.
    Closes #57
2026-10-17 Safety state machine runs from a rules table; docs generated from it
    The transitions now live in firmware/components/safety/src/safety_rules.def
    (SAFETY_RULE rows, checked in order) together with the per-state outputs
    and documented signal rules (fusion, cooking, timers, holds). evaluate()
    walks the table; the guards are small named functions in safety.c.
    Behaviour is unchanged: the 63 safety unit tests pass, and 400 randomised
    runs (about 6 million steps, every transition type) give identical traces
    before and after.
    tools/safety_rules.py gen writes docs/safety_rules.md from the table, the
    Kconfig defaults and the safety.c constants. tools/safety_rules.py check
    fails if the doc is stale, t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
2026-10-17 Dashboard: Safety logic card generated from the rules table
    tools/safety_rules.py gen now also writes frontend/js/safety_rules_data.js
    from safety_rules.def, and check fails if it is stale, so the dashboard
    shows exactly the rules the controller runs. New Safety logic card:
    Monitor shows the reported state, its outputs and the rules that can fire
    next; Tuning gets a Logic tab with every transition (current state's rules
    highlighted, last rule that fired matched from the event log), outputs per
    state and the signal rules, with an active hold highlighted.
    Claude-Session: https://claude.ai/code/session_01UsGKjDi8Brw4DGhcBXrEZ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
2026-10-17 Make every safety setting tunable from the dashboard
    Every number and choice the rules table names can now be changed from the
    dashboard. The ones without a card of their own (policies, fault, node and
    valve timings, the tier, trend and hold fine tuning) are rows of one table,
    firmware/components/rb_params/include/rb_params.def, which drives:
    - a "params" / "params_defaults" controller command, saved in NVS and
    reported as safety.params / params_source (RB_CTRL_REMOTE_PARAMS, on);
    - the safety.c constants becoming safety_config_t fields (0 = built-in,
    same behaviour: 400 randomised runs identical);
    - tools/safety_rules.py gen writing Django's copy, the dashboard's copy
    and the schema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
2026-10-23 Keep the Mac awake while run_dev.sh runs (#37)
    run_dev.sh starts caffeinate -i -s -w on macOS so idle or system sleep
    doesn't stop the broker, subscriber and dashboard during long tests.
    RB4107_ALLOW_SLEEP=1 turns it off. docs/setup.md covers the lid, power
    and automatic updates for multi-day runs.
    Claude-Session: https://claude.ai/code/session_01KrC112vK9Z8BozABTF5RKm
2026-10-23 Stall history: per-stall record of unattended, warning and shutdown incidents
    Django builds one Incident per unattended-cooking episode from the
    controller's live telemetry (no firmware change): opened on UNATTENDED,
    WARNING or SHUTDOWN, raised as it escalates, closed on MONITORING, IDLE or a
    controller restart. Never pruned. New GET /api/stall-history/ and a
    "Stall history" dashboard tab, plus an "Incident history" button on the
    stall page. seed_incident_history (run by run_dev.sh --demo) gives the
    simulated stalls two months of made-up past incidents, marked demo.
    Claude-Session: https://claude.ai/code/session_016N9h4Tio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
2026-10-23 Logs tab: controller log lines and log levels on the dashboard (#58)
    The controller copies every line it logs (same lines and per-tag levels as the
    serial port) into a ring buffer; the telemetry task publishes them in batches
    on <prefix>/controller/log with the log levels in force. Django stores them as
    LogLine rows (7 days) and serves /api/devices/<id>/logs/ with level, tag and
    text filters. A new Tuning > Logs tab shows them live and edits per-tag levels
    through a new controller_command action log_level / log_level_defaults
    (until reboot, like the console's `log` command, which now shares the same
    level table).
    Copying never waits, so logging can't hold up the safety task. New Kconfig:
    RB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
2026-10-23 Send Telegram alerts to staff on buzzer and shutdown
    The MQTT subscriber now turns the controller's warning and shutdown events
    into a Telegram message to the configured chats (ingest/alerts.py, called
    from handle_event). Off until RB4107_TELEGRAM_BOT_TOKEN and
    RB4107_TELEGRAM_CHAT_IDS are set in django/.env. RB4107_ALERT_EVENTS also
    offers unattended and fault. Sent in a background thread; retained and
    stale queued events are skipped. `manage.py telegram_alerts` finds chat IDs
    and sends a test message. No firmware or dashboard change.
    Claude-Session: https://claude.ai/code/session_01NNwxYzFX2Ymujm7sWXvvzz
2026-10-24 Controller defaults to Wi-Fi only; docs say Wi-Fi and 8DI-8DO
    The controller now reaches MQTT over Wi-Fi only (decided 2026-10-23), so
    RB_NET_TYPE defaults to the Wi-Fi station. The Ethernet options stay but
    are marked unused. Docs and comments that described Ethernet as the main
    link now say Wi-Fi, and the Kconfig menu, comments and sdkconfig.defaults
    name the board correctly (ESP32-S3-POE-ETH-8DI-8DO, not 8DI-8RO).
    docs/configuration.md regenerated, keeping its hand-written quick index.
    Claude-Session: https://claude.ai/code/session_01MhHwQv5wPbJ7zVxf29gLMm
2026-10-31 Telegram alerts: Acknowledge button that records who responded
    Each Telegram alert now carries an "Acknowledge alert" button. The MQTT
    subscriber runs a long-polling thread (alerts.poll_acks) that picks up
    presses, records who acknowledged and when in a new TelegramAlert table,
    and edits the message in every alert chat to show it. Only the first press
    counts; presses from unknown chats or alerts are refused. No public address
    or webhook is needed.
    `manage.py telegram_alerts` now lists the last 10 alerts and their ack
    status, and --find-chats resets Telegram's update filter. Docs updated.
    No firmware or safety-rule changes; tools/safety_rules.py check passes.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
2026-10-31 Five temperature tiers, rate rule and falling hold for the countdown
    - Tier 1 (base) 150/300 s, tiers 2-5 from 100/150/200/250 C at
    120/240, 90/180, 60/120, 30/60 s (buzzer steps 30 s, shutdown 2x).
    - Rate rule: a pan rising fast enough to reach a tier within that tier's
    buzzer time gets it already (median-halves rate over 30 s).
    - Falling hold: a due buzzer/shutdown waits while the temperature falls,
    until it rises, heat is confirmed, or 90 s per countdown.
    - A stricter tier never restarts the countdown (test added).
    - tiers command, NVS (version 2), telemetry, Django, schema and the
    dashboard tier card carry tiers 2-5; new rb_params rows.
    - Rules table, generated docs and safety_st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
2026-11-01 Controller: backup Wi-Fi network (e.g. phone hotspot) and a second fallback broker host
    RB_WIFI_SSID_2/RB_WIFI_PASSWORD_2: the controller starts on RB_WIFI_SSID and
    switches to the other network after RB_WIFI_SWITCH_AFTER (3) failed attempts
    in a row, alternating until one works. RB_BROKER_FALLBACK_HOST_2 joins the
    broker rotation for the MacBook's IP on the hotspot. The mqtt console command
    shows the SSID in use. All new options default to empty/off.
    Claude-Session: https://claude.ai/code/session_01RxeLFoAdR36B1B9n9wzvBi
2026-11-01 Dashboard: offline stalls and sensor nodes are faults; one stall status rule
    A controller that reports IDLE/MONITORING while its sensor nodes are offline
    showed as Normal. Now every controller gets one status by an ordered rule
    (critical, warning, fault, unknown, normal) in classify_display_state():
    fault covers a controller FAULT, a controller that is offline / stale /
    never heard, an old safety state, any listed sensor node not ONLINE or
    invalid, and no nodes at all. The separate Connectivity issue card and
    filter are gone; offline stalls count as Fault. Unknown now outranks normal
    when a stall has several controllers. Rule documented in docs/dashboard.md,
    tests in ingest/tests/test_stall_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
2026-11-01 Steadier cooling judgment: room temperature, rates and a jump-proof trend (#70)
    * Cooling judgment and falling hold measured against the room temperature
    The thermal node now sends the room temperature (10th-percentile pixel of the
    frame; protocol v3). The controller keeps it between 30 and 45 degC, with
    38 degC when there is no reading (B5).
    - D1: a pan counts as only cooling when its predicted settling temperature is
    under room + 10 degC (never above the cooking temperature), instead of under
    the fixed off temperature.
    - D5: falling means losing at least 2 %/min of the heat above the room (and at
    least 1 degC/min), instead of a fixed 2 degC/min.
    - New dashboard settings: room min/m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
2026-11-01 Telegram alerts: say where the stall is; hint to run migrate
    Alerts now have a "Location:" line from the location catalogue (site,
    building, level, area), skipping placeholder values. `manage.py
    telegram_alerts` prints "Run: python manage.py migrate" instead of a
    traceback when the alert table doesn't exist yet. Docs updated.
    Claude-Session: https://claude.ai/code/session_01Rvn3tNcj5WzWk48pCVfFca
2026-11-01 Add simulate_alert: play one incident to try the dashboard and Telegram
    `python manage.py simulate_alert` publishes what a controller would for one
    sped-up unattended-cooking incident (cooking, person leaves, buzzer event,
    shutdown event, reset), through the broker or directly with --direct, so
    the dashboard, the incident history and the Telegram alerts with their
    Acknowledge button can be checked without hardware. Messages are marked
    "simulation": true. Docs and tests added.
    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
2026-11-03 Radar tab: drop hold, lock time, report period and threshold editing
    The C4002 disappear delay, lock time and report period are design choices
    (the S3 does all debouncing; nodes report on every change plus every
    500 ms), and the per-gate thresholds come from Calibrate. The Radar tab no
    longer offers them: "Apply settings" sends only range, gate size and the
    two sensitivities, and the gate table shows the thresholds read-only.
    Django and the firmware still accept all these keys; the wire protocol is
    unchanged. Docs updated (c4002_tuning.md, dashboard.md).
2026-11-03 Stall history: period picker and per-stall figures for inspectors
    The Stall history tab now answers, per stall over the last 2 weeks,
    4 weeks (default) or 3 months: how often the unattended-cooking
    countdown starts (count, per week, per cooking day), how many reached
    the buzzer and the gas shut-off (counts and shares), and how long
    recovery usually takes (median and slowest, by how it ended). Laid out
    for a laptop: all stalls in a sortable table on the left, the chosen
    stall's figures, weekly stacked bar chart, recovery table and incident
    list on the right.
    - /api/stall-history/ takes days=14|28|90 (anything else is a 400) and
    adds each stall's period summary; without it the all-time resp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
2026-11-03 Safety tab: settings in two levels, each card applied on its own; fix 30 rule settings
    - One Safety tab replaces Rules and Logic: a flow strip (Idle -> Monitoring ->
    Unattended -> Warning -> Shutdown, live values on the arrows), three step
    cards (cooking / person / timer) with their main settings and "More
    settings", an Apply per card, Restore defaults, and a folded Full rule table.
    - 30 settings in the rules are now fixed ({=NAME} in safety_rules.def):
    rb_params.def keeps 8. tools/safety_rules.py accepts {=NAME} and drops
    removed params from the MQTT schema.
    - The controller saves the presence filter and buzzer/shutdown times in NVS
    like the other dashboard settings.
    - MQTT clie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
2026-11-03 Dashboard: every dropdown the same height as the text fields beside it
    A native select comes out a pixel or more shorter than an input with the same
    padding; both now get an explicit height (36 px in forms and filters, 32 px in
    the small range pickers, 30 px in the heat map footprint). The tier table's
    inputs match the 36 px fields around them.
2026-11-03 Stall history: your own period, compare stalls by any measure, whole row opens
    - Period: besides 2 weeks / 4 weeks / 3 months, "Your own…" takes the last
    N days (1-366) or a from/to date range. /api/stall-history/ accepts
    days=N or from=&to= (whole local days, not past today, at most 366
    days); anything else is a 400. The browser remembers the choice.
    - Compare stalls: find by name or place, filter by site/terminal, show only
    starred stalls or those with a shut-off, buzzer or restart, and rank by
    any of 15 measures (per week, per cooking day, shares, usual/slowest
    recovery, time back after the buzzer, reset after a shut-off, restarts),
    worst or best first. A measure without i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
2026-11-03 Docs overhaul; remove the valve node and the controller's valve link
    The controller drives the shutdown itself through output 1 (energised while
    safe), so the separate valve node is gone: firmware/valve_node, the servo and
    valve_link bench tests, valve_logic, servo, rb_valve_link, the Valve node
    Kconfig menus, VALVE_COMMAND/VALVE_STATUS (types 5 and 6, role 3 are retired),
    the wired valve line in shutdown_output, and safety rule X1.
    Docs: add overview, status and glossary; merge mqtt_topics into mqtt_schema;
    compress dashboard, architecture, safety_state_machine, remote_reset,
    c4002_tuning, telegram_alerts, setup and logging; fix protocol v3 and 150 s
    warning default; move the handover's co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
2026-11-03 Django: stall history by any period, clearer stall status wording, richer demo
    - Stall history API takes ?days=N or ?from=&to= (whole days, at most 366)
    and counts incidents and cooking days over that period.
    - Stall status titles and reasons reworded (GAS SHUT OFF, CONTROLLER FAULT,
    UNATTENDED · BUZZER WARNING, per-node 'node_01: offline').
    - Demo: seeded events for the simulated stalls (demo_events.py), more
    simulate_fleet scenarios; seed_incident_history uses them.
    - Tests updated and added; manage.py test ingest: 199 pass.
2026-11-03 Dashboard: stall history period picker and compare table, wording, tests
    - Stall history: choose the period (2 or 4 weeks, 3 months, custom days or
    dates), compare stalls with any ranking, open a stall from its whole row.
    - Countdown card, event text (event_text.js), radar and Safety tab wording
    aligned with the controller's labels ('Reset shut-off', 'buzzer warning').
    - Layout and styling for the new views; frontend/tests: 34 pass
    (node --test frontend/tests/).
2026-11-03 Safety: clamp the room temperature to 36-45 °C
    ROOM_MIN_C 30 -> 36 (requested). Updated the two tests that assert the clamp,
    the state-machine doc, and the generated rules doc and dashboard copy.
    safety_rules.py check passes and the 79 safety tests pass.
2026-11-03 Dashboard: the Countdown card names the kind of hold, what ends it and its limit
    Cooling (sure no heat is going in; limit 4 x the cookware time constant),
    falling (not sure yet whether it is cooling or a lowered flame; limit the
    falling hold maximum) and return (a person is being confirmed). The cooking
    tile says which hold applies. New test: countdown_hold.test.mjs; 38 frontend
    tests pass.
2026-11-03 Dashboard: drop the bracketed text from the hold labels and titles
2026-11-03 Docs: note the cooling-only countdown limit in the stall history (issue #72)
2026-11-03 Stall history: count only the countdowns that reached the buzzer
    A countdown that ends before the buzzer is the time the cook is allowed to be
    away, so it is stored but no longer counted or listed. This also leaves out a
    switched-off pan that was still hot when the cook left (its buzzer is held).
    - incidents.py: the history counts peaks warning and shutdown only. New period
    figures: buzzer_per_week, buzzer_per_cooking_day, shutoff_share, usual_recovery
    (buzzer to normal) and reset_after_shutoff. Removed: countdowns, countdowns_per_*,
    buzzer_share, before_buzzer and countdown_only.
    - Dashboard: four figures (buzzer warnings, recovery after the buzzer, shut-offs,
    reset after a shut-of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
2026-11-03 Safety: cooking is decided by temperature and direction
    - On: the hottest pixel reaches the cooking temperature (50 C) and is not still
    falling (the thermal node's rate under -0.2 C/min blocks it), so a hot pan put
    in view or one that was switched off is not cooking until the fall stops.
    - Off: below the off temperature, which now defaults to 50 C (no gap), or below
    60 C and falling by 0.5 C/min or more. A steady or turned-down pan stays
    cooking until it is below 50 C; a pan in the 50-60 C band that stops falling
    counts as cooking again. An unknown rate never stops cooking.
    - Rules B1-B3 reworded, new signal B6; 60 C and the two rates are fixed in
    safety.c ({=NAME}). Kconfig RB_S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
2026-11-03 Safety: cooking-over default 47 °C (a 3 °C margin below the 50 °C cooking temperature)
    A pan hovering at 50 °C no longer flips between idle and monitoring on every
    reading. RB_SAFETY_HEAT_OFF_DC default 500 -> 470; tests and docs updated.
    84 safety tests, rules check, Django and frontend tests pass.
2026-11-04 Safety: check a falling pan before the countdown; unclear buzzer warnings in Stall history
    The controller can't reliably tell a stove switched off from one turned down,
    so it now waits before starting a countdown, and the history flags the
    episodes that may have been a switched-off stove.
    Firmware (rule T09, new D6): when the absence is confirmed, the countdown
    waits (hold "checking", state stays MONITORING) for a first look of half the
    rate window (15 s), skipped if the pan is rising or the buzzer is due, then
    only while the pan falls, at most the falling hold's 90 s, which it shares.
    The time away still counts from when the absence began, so no buzzer is ever
    later. 5 new safety tests (89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
2026-11-04 Demo: a live "checking" stall (food court station B)
    Cooking station B of the Demo food court stall now plays the checking
    scenario: a burner switched off at 180 °C, nobody there, the countdown
    waiting to start (hold "checking", time away running). It starts over
    just before the 90 s limit so the stall stays in the check.
